danwerner21/mini68k/hardware/mfpic/INT-NS32202.tif

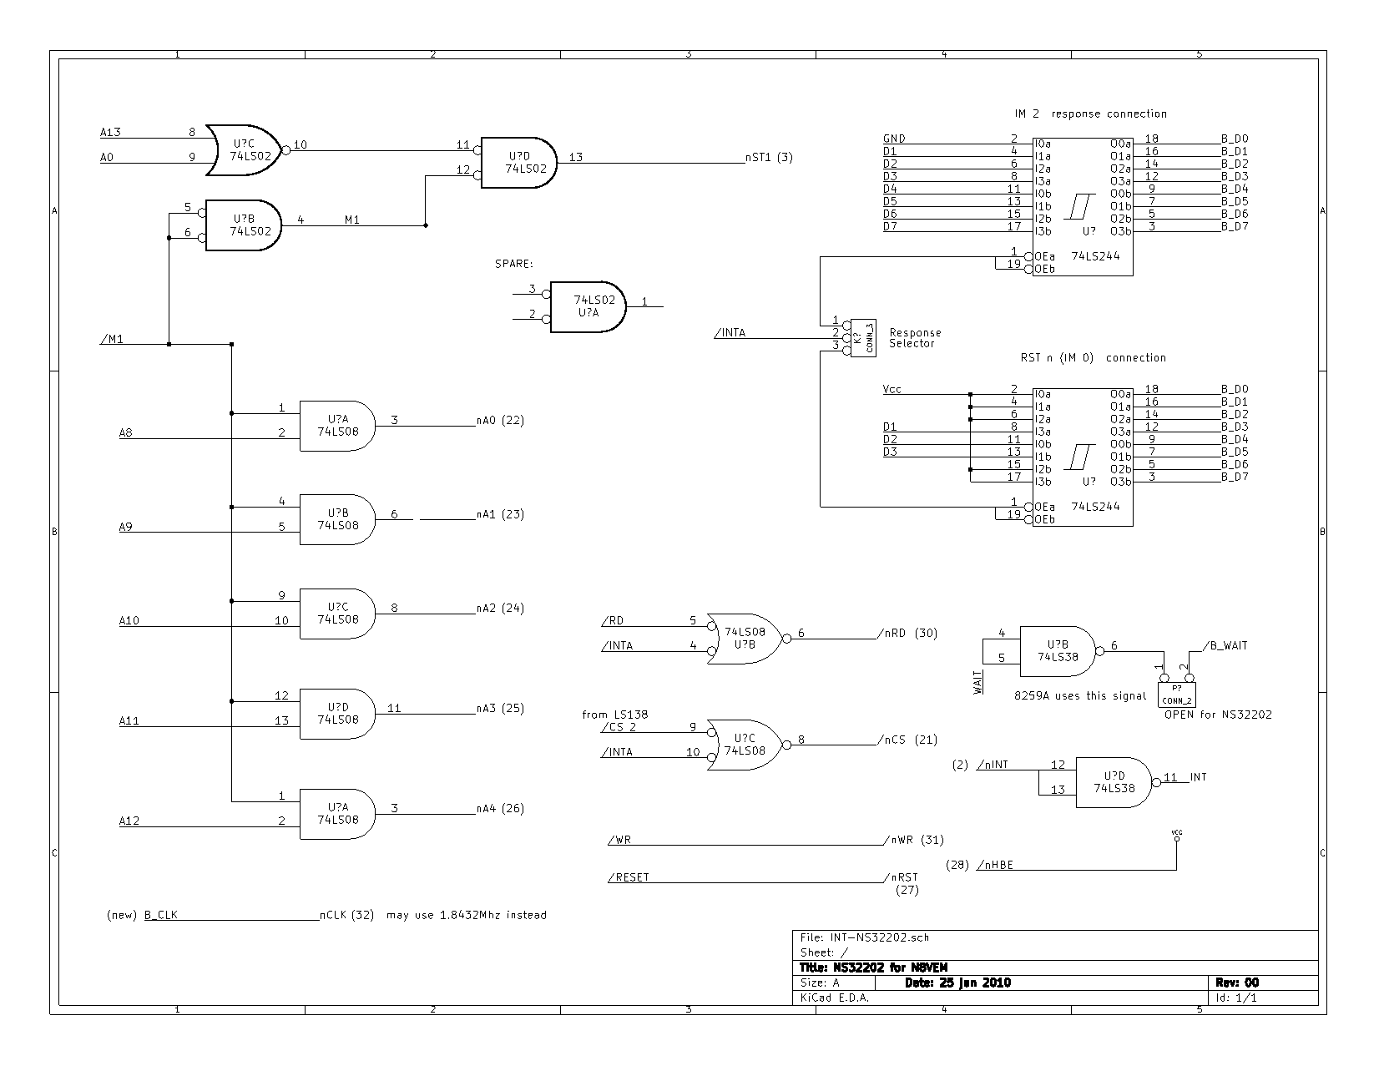
hardware/mfpic/INT-NS32202.tif
