danwerner21/mini68k/hardware/sbc/PC-bot-mirror.png

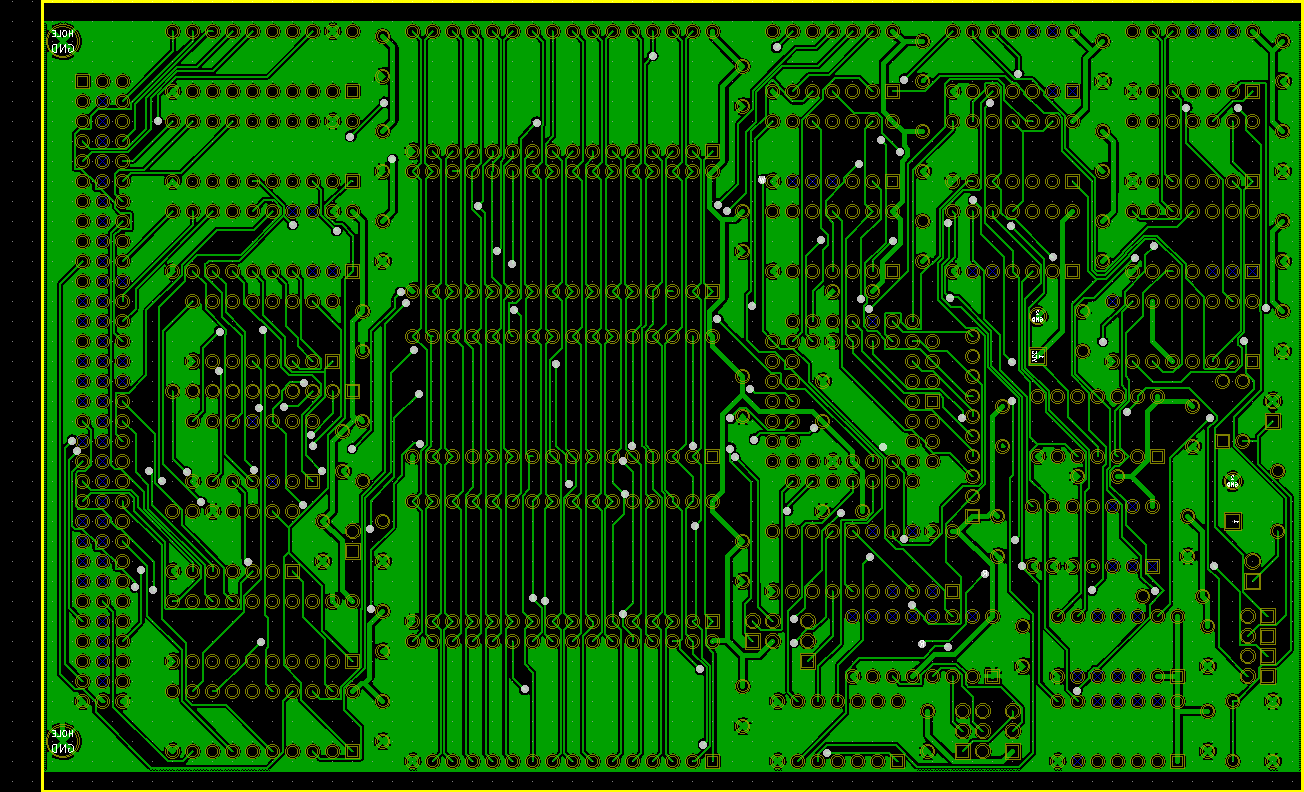
hardware/sbc/PC-bot-mirror.png
