danwerner21/mini68k/hardware/sbc/PC-bottom.png

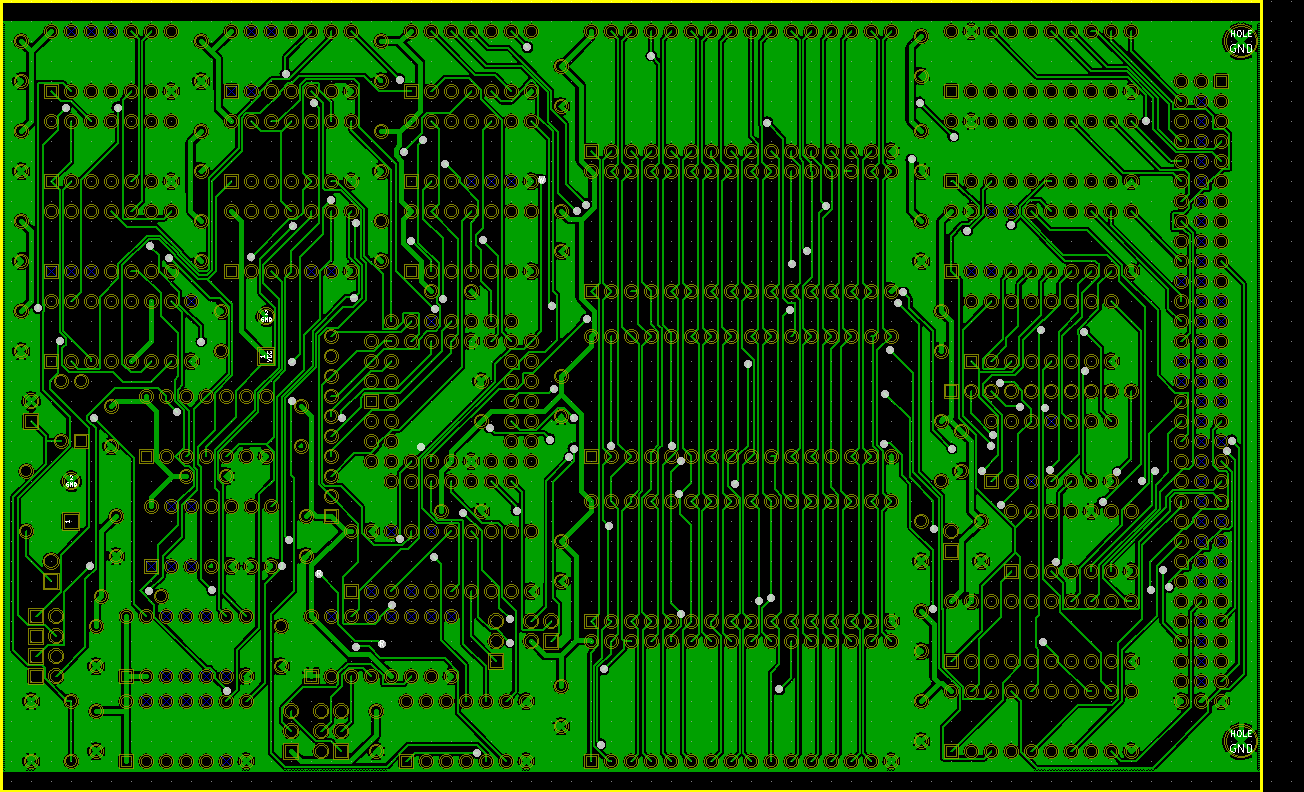
hardware/sbc/PC-bottom.png
