danwerner21/mini68k/hardware/sbc/PC-top.png

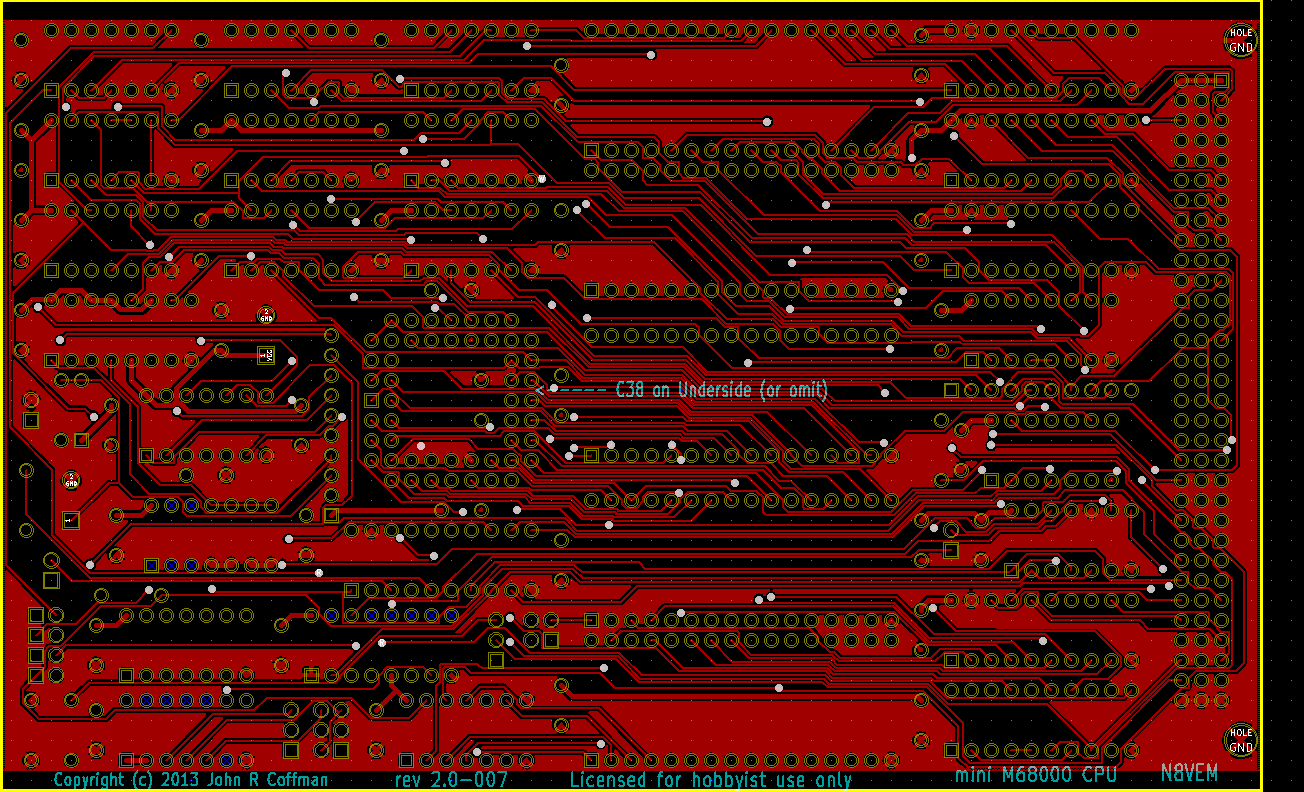
hardware/sbc/PC-top.png
