danwerner21/mini68k/hardware/sbc/Placement.png

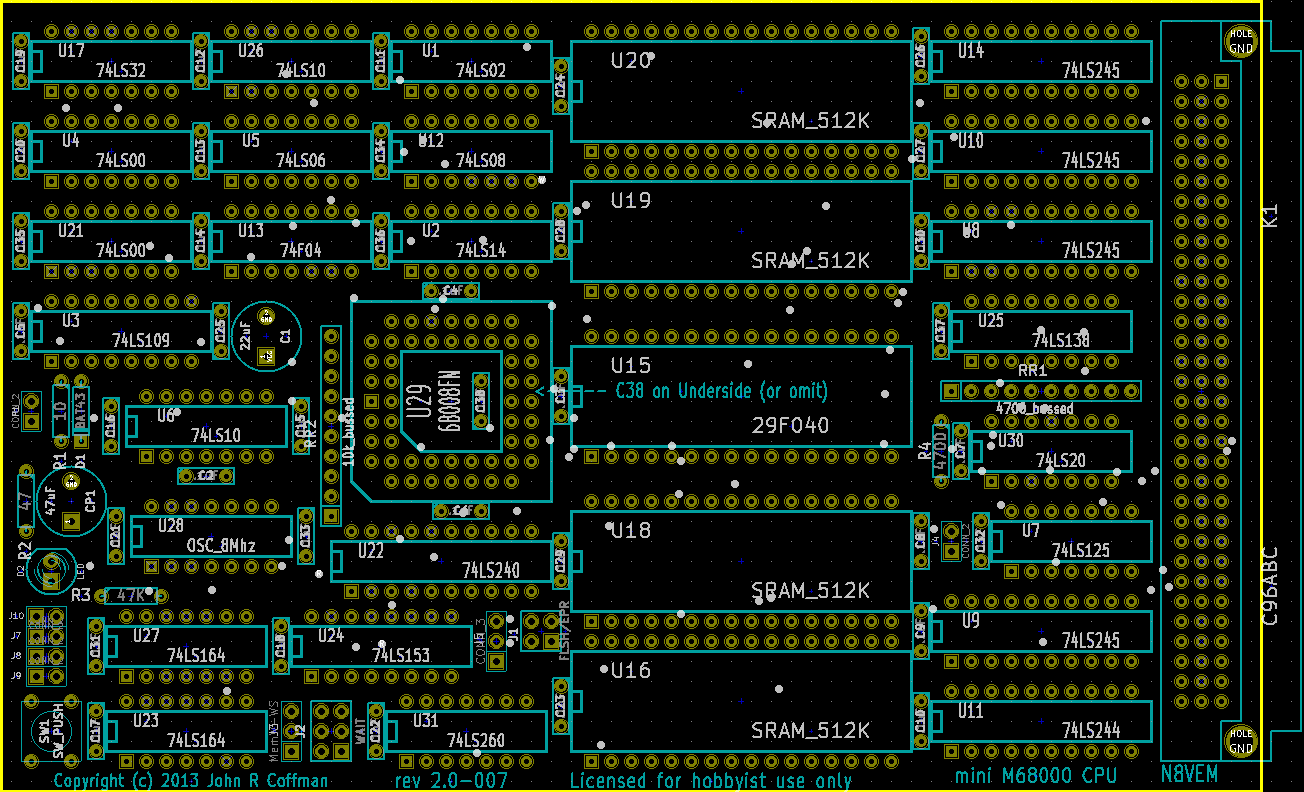
hardware/sbc/Placement.png
