danwerner21/mini68k/hardware/sbc/babyM68K.csv

Reference | Qty | Value | DNP | Exclude from BOM | Exclude from Board | Footprint | Datasheet
C1 | 1 | 22uF
C2,C3,C4,C5,C6,C7,C8,C9,C10,C11,C12,C13,C14,C15,C16,C17,C18,C19,C20,C21,C22,C23,C24,C25,C26,C27,C28,C29,C30,C31,C32,C33,C34,C35,C36,C37,C38 | 37 | .1uF
CP1 | 1 | 47uF
D1 | 1 | BAT43
D2 | 1 | LED
J1 | 1 | FLSH/EPR
J2 | 1 | WAIT
J3 | 1 | MemW-WS
J4,J7,J8,J9,J10,P1 | 6 | CONN_2
J5 | 1 | CONN_3
K1 | 1 | C96ABC
R1 | 1 | 10
R2 | 1 | 47
R3 | 1 | 47K
R4 | 1 | 4700
RR1 | 1 | 4700 bussed
RR2 | 1 | 10k bussed
SW1 | 1 | SW_PUSH
U1A?,U1B?,U1C?,U1D? | 4 | 74LS02
U2A?,U2B?,U2C?,U2D?,U2E?,U2F? | 6 | 74LS14
U3A?,U3B? | 2 | 74LS109
U4A?,U4B?,U4C?,U4D?,U21,U21B?,U21C?,U21D? | 8 | 74LS00
U5A?,U5B?,U5C?,U5D?,U5E?,U5F? | 6 | 74LS06
U6A?,U6B?,U6C?,U26,U26B?,U26C? | 6 | 74LS10
U7A?,U7B?,U7C?,U7D? | 4 | 74LS125
U8,U9,U10,U14 | 4 | 74LS245
U11 | 1 | 74LS244
U12,U12A?,U12C?,U12D? | 4 | 74LS08
U13,U13A?,U13B?,U13D?,U13E?,U13F? | 6 | 74F04
U15 | 1 | 29F040
U16,U18,U19,U20 | 4 | SRAM_512K
U17,U17A?,U17B?,U17C? | 4 | 74LS32
U22 | 1 | 74LS240
U23,U27 | 2 | 74LS164
U24 | 1 | 74LS153
U25 | 1 | 74LS138
U28 | 1 | OSC 8Mhz
U29 | 1 | 68008FN |  |  |  | PLCC52
U30A?,U30B? | 2 | 74LS20
U31A?,U31B? | 2 | 74LS260
