danwerner21/mini68k/hardware/mfpic/PIC-007-sch.pdf

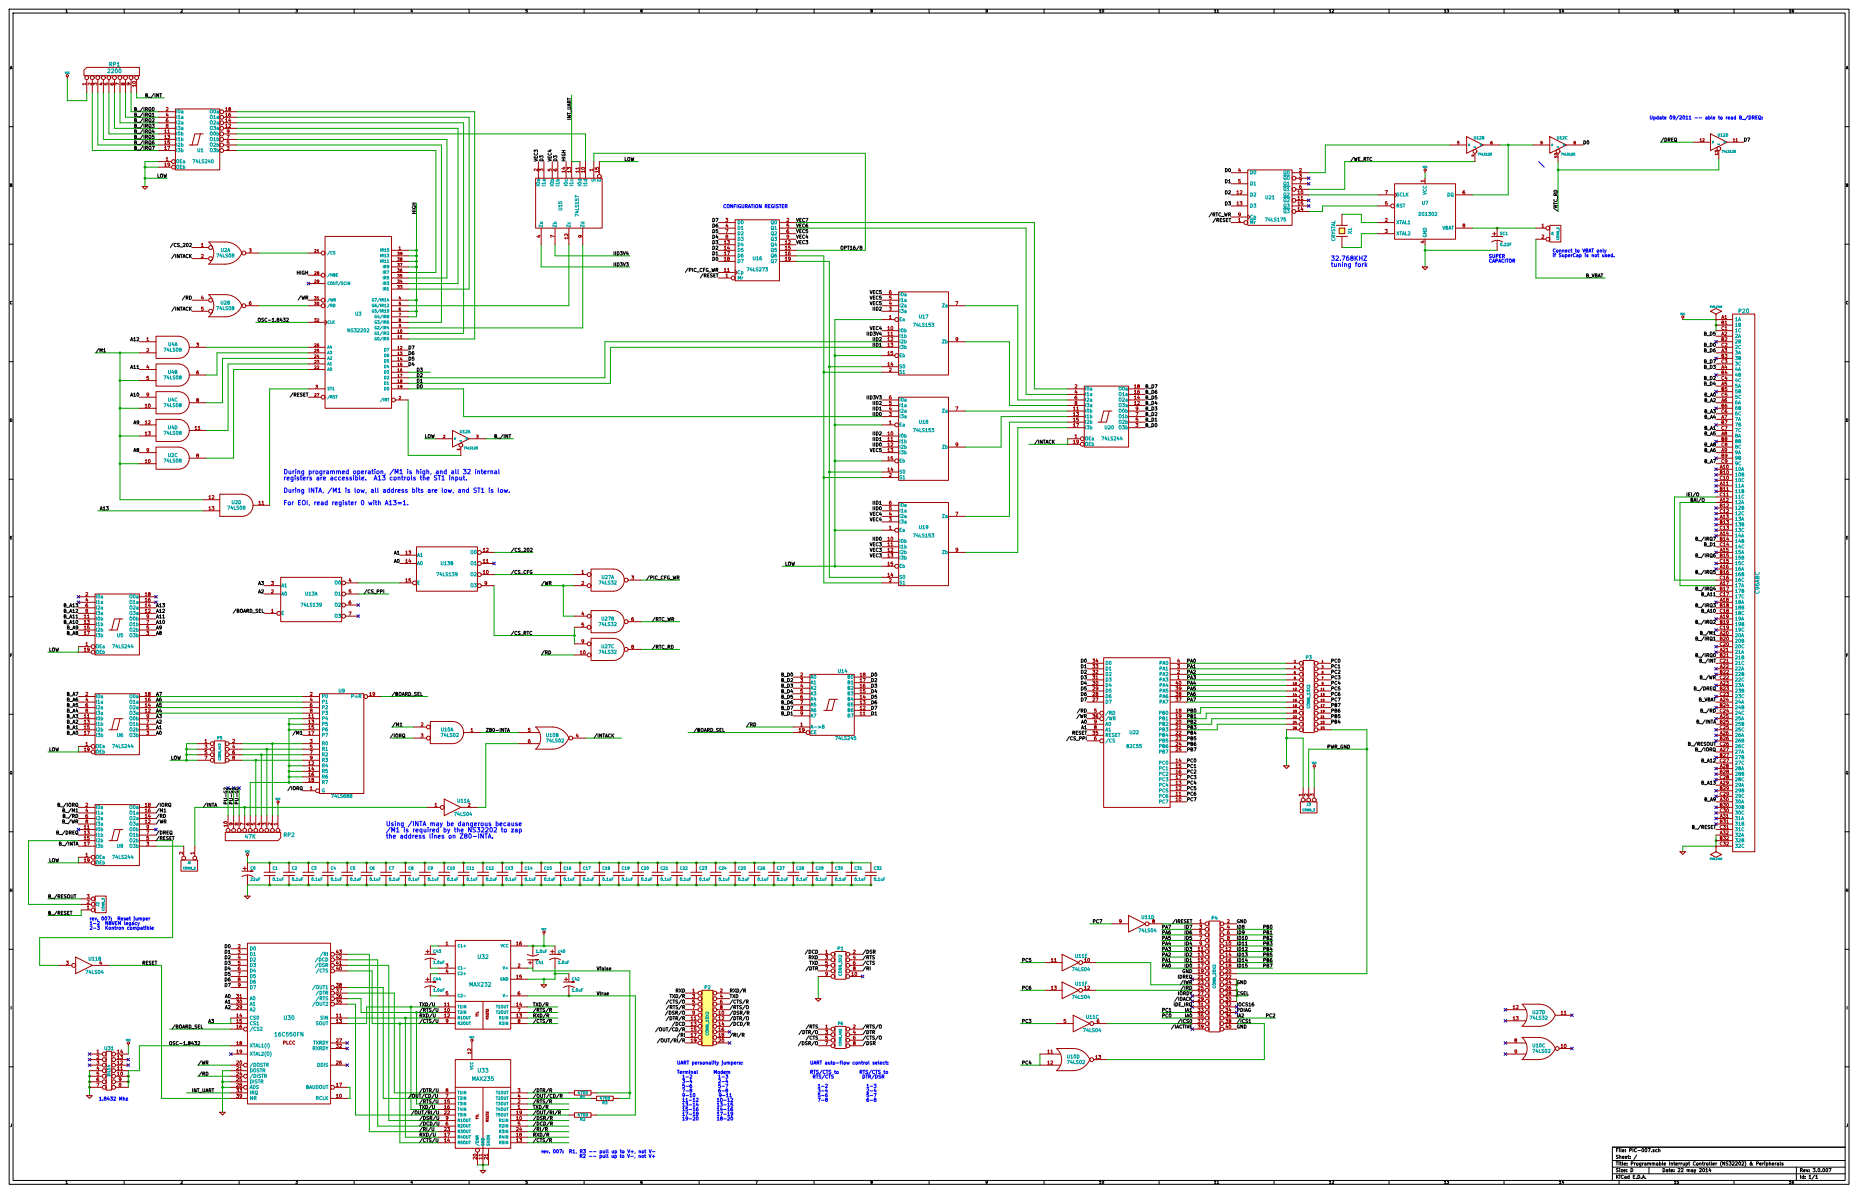
[picture p9: page 1]

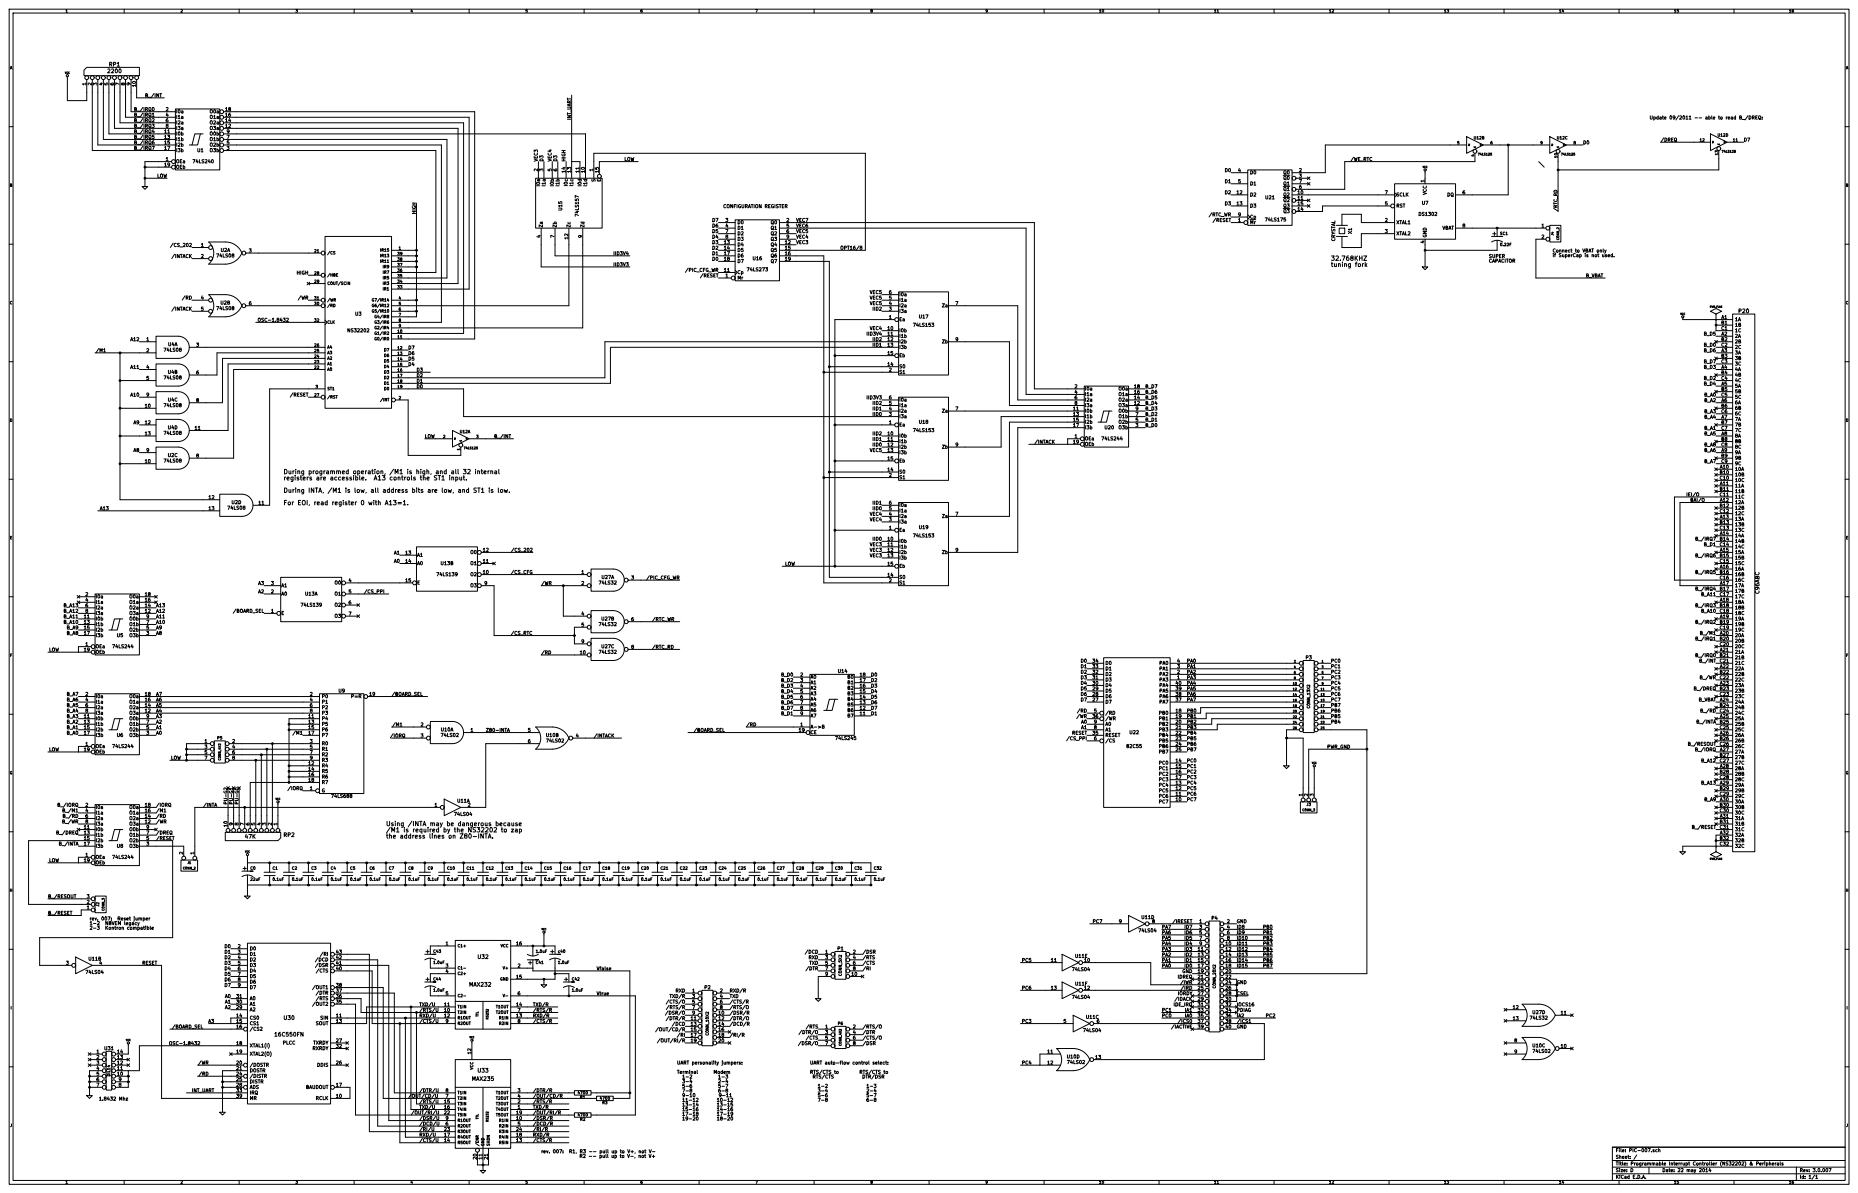
[picture p10: page 2]
