danwerner21/mini68k/(list of files, drawings)

Other design files:
hardware/mfpic/PIC-007-88.dsn
hardware/mfpic/PIC-007.dsn
hardware/sbc/babyM68K-112c.dsn
hardware/sbc/babyM68K.dsn
