danwerner21/mini68k/hardware/sbc/babyM68K.kicad_pcb

## KiCad design hardware/sbc/babyM68K.kicad_pcb (2026-08-16)

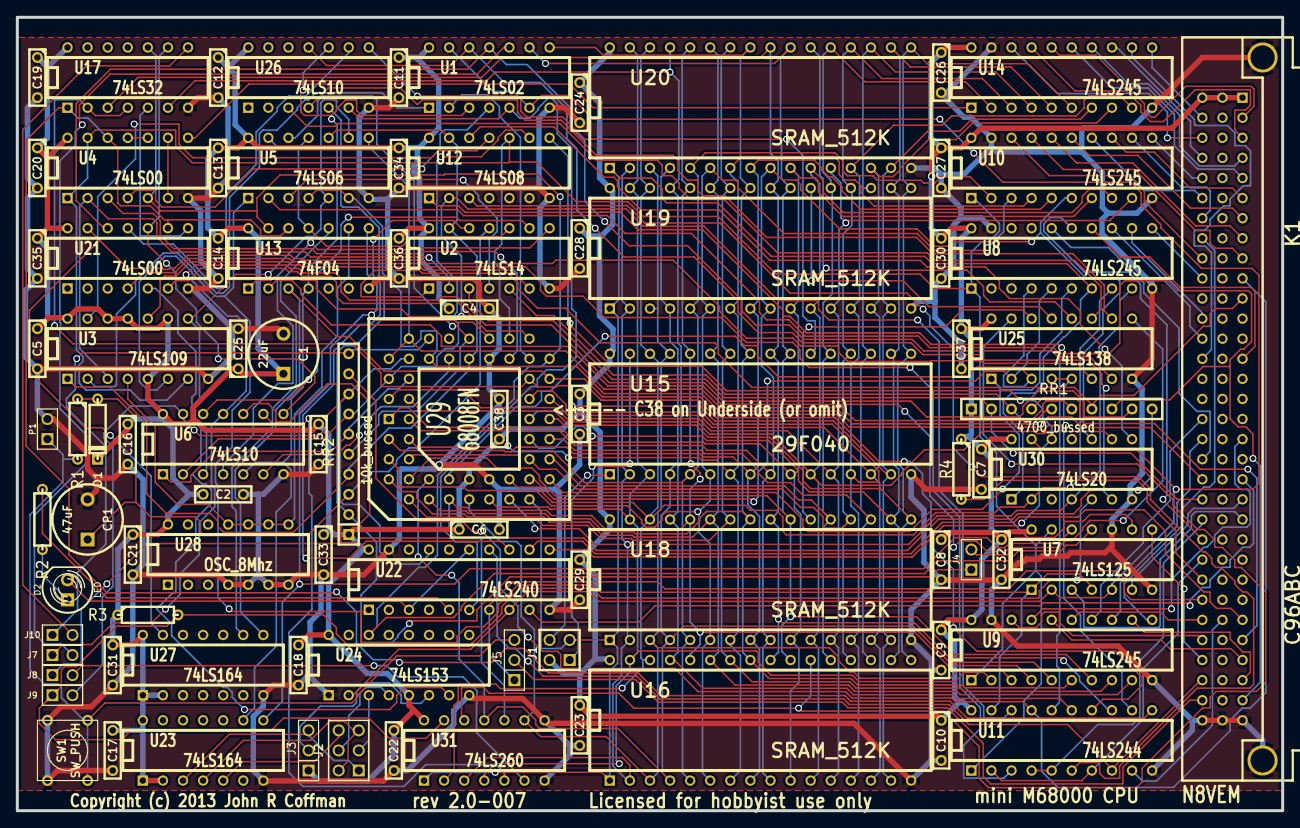
[picture p11: board babyM68K.kicad_pcb from above]

Board: 2 copper layers, 160.0 x 100.3 mm, 90 parts (0 on the bottom side), 163 nets.

Parts:
C1: 22uF; C2V8
C2, C3, C4, C5, C6, C7, C8, C9, C10, C11, C12, C13, C14, C15, C16, C17, C18, C19, C20, C21, C22, C23, C24, C25, C26, C27, C28, C29, C30, C31, C32, C33, C34, C35, C36, C37, C38: .1uF; C2
CP1: 47uF; C2V8
D1: BAT43; D3
D2: LED; LED-5MM-POL
J1: FLSH/EPR; PIN_ARRAY_2X2
J2: WAIT; pin_array_3x2
J3: MemW-WS; PIN_ARRAY_3X1
J4, J7, J8, J9, J10: CONN_2; PIN_ARRAY_2X1
J5: CONN_3; PIN_ARRAY_3X1
K1: C96ABC; C96ABCMC_52
P1: CONN_2; PIN_ARRAY_2X1
R1: 10; R3
R2: 47; R3
R3: 47K; R3
R4: 4700; R3
RR1: 4700_bussed; r_pack9
RR2: 10k_bussed; r_pack9
SW1: SW_PUSH; SW_PUSH_SMALL
U1: 74LS02; DIP-14__300_52
U2: 74LS14; DIP-14__300_52
U3: 74LS109; DIP-16__300_52
U4, U21: 74LS00; DIP-14__300_52
U5: 74LS06; DIP-14__300_52
U6, U26: 74LS10; DIP-14__300_52
U7: 74LS125; DIP-14__300_52
U8, U9, U10, U14: 74LS245; DIP-20__300_52
U11: 74LS244; DIP-20__300_52
U12: 74LS08; DIP-14__300_52
U13: 74F04; DIP-14__300_52
U15: 29F040; DIP-32__600_52
U16, U18, U19, U20: SRAM_512K; DIP-32__600_52
U17: 74LS32; DIP-14__300_52
U22: 74LS240; DIP-20__300_52
U23, U27: 74LS164; DIP-14__300_52
U24: 74LS153; DIP-16__300_52
U25: 74LS138; DIP-16__300_52
U28: OSC_8Mhz; DIP-14__300_52
U29: 68008FN; PLCC52_52
U30: 74LS20; DIP-14__300_52
U31: 74LS260; DIP-14__300_52

Connections:
/AS: U11.12, U13.3, U25.4, U25.5, U27.8, U29.31
/BERR: J10.1, RR2.10, U29.44
/BG: U1.2, U29.35
/BGACK: U3.7, U4.1, U4.13, U7.13, U8.1, U9.1, U10.1, U11.1, U12.10, U29.36
/BR: U4.3, U29.37
/CLK: U3.4, U13.9, U28.8, U28.9, U28.10, U28.11
/CSRAM0: U16.22, U25.15, U31.12
/CSRAM1: U18.22, U25.14
/CSRAM2: U19.22, U25.13
/CSRAM3: U20.22, U25.12
/DS: U11.14, U17.2, U17.4, U29.32
/DTACK: U21.6, U29.34
/HALT: RR2.5, U5.12, U29.40
/IPL0: RR1.6, U5.8, U29.46, U29.47
/IPL1: RR1.5, U5.4, U5.6, U29.45
/Memory//USERLOWMEM: U6.8, U17.9, U21.10
/POClear: U13.10, U27.9
/RD: U11.13, U15.24, U16.24, U17.3, U18.24, U19.24, U20.24
/RESET: RR2.4, U2.13, U3.1, U5.10, U12.13, U29.41
/ROM: U15.22, U26.8
/Reset//RESET_IN: J5.3, P1.1, R1.2, SW1.2
/Select//IOSPACE: U1.12, U26.11, U30.6
/Select//ROMONLY: U21.13, U25.6, U27.13
/Select/PU-10K-A: J4.1, RR2.2, U26.5
/Tranceivers/D_OUT: U4.8, U14.1
/Tranceivers/LOCAL: U1.4, U4.4
/VPA: U6.6, U29.43
/WAIT: U11.3, U21.4
/WR: U11.15, U16.29, U17.6, U18.29, U19.29, U20.29
/Wait_State/1WS: J2.1, J3.3, U23.3
/Wait_State/2WS: J2.2, J2.5, U23.4
/Wait_State/3WS: J2.6, U23.5
/Wait_State/RDY: U21.5, U24.7
/Wait_State/WS-IORD: J2.3, U24.3
/Wait_State/WS-IOWR: J2.4, U24.4
A0: U10.9, U15.12, U16.12, U18.12, U19.12, U20.12, U29.51
A1: U10.8, U15.11, U16.11, U18.11, U19.11, U20.11, U29.52, U30.9
A2: U10.7, U15.10, U16.10, U18.10, U19.10, U20.10, U29.1
A3: U10.6, U15.9, U16.9, U18.9, U19.9, U20.9, U29.2, U30.10
A4: U10.5, U15.8, U16.8, U18.8, U19.8, U20.8, U29.3
A5: U10.4, U15.7, U16.7, U18.7, U19.7, U20.7, U29.4
A6: U10.3, U15.6, U16.6, U18.6, U19.6, U20.6, U29.5
A7: U10.2, U15.5, U16.5, U18.5, U19.5, U20.5, U29.6
A8: U9.9, U15.27, U16.27, U18.27, U19.27, U20.27, U29.7
A9: U9.8, U15.26, U16.26, U18.26, U19.26, U20.26, U29.8
A10: U1.9, U9.7, U15.23, U16.23, U18.23, U19.23, U20.23, U29.9
A11: U1.8, U9.6, U15.25, U16.25, U18.25, U19.25, U20.25, U29.10
A12: U9.5, U15.4, U16.4, U18.4, U19.4, U20.4, U29.11, U31.11
A13: U9.4, U15.28, U16.28, U18.28, U19.28, U20.28, U29.12, U31.10
A14: U9.3, U15.29, U16.3, U18.3, U19.3, U20.3, U29.14, U31.9
A15: U9.2, U15.3, U16.31, U18.31, U19.31, U20.31, U29.16, U31.4
A16: U8.9, U15.2, U16.2, U18.2, U19.2, U20.2, U29.18, U30.4, U31.3
A17: U8.8, U15.30, U16.30, U18.30, U19.30, U20.30, U29.19, U30.2, U31.2
A18: J1.3, U8.7, U16.1, U18.1, U19.1, U20.1, U29.20, U30.1, U31.1
A19: U8.6, U25.1, U29.21
A20: U8.5, U25.2, U29.22
A21: U8.4, U25.3, U29.13
AS: U1.3, U6.5, U13.4, U23.9, U26.10
BUSAK: U3.6, U5.1, U7.1, U7.4, U11.19, U22.1
B_/BUSAK: K1.A31, RR1.8, U5.2
B_/BUSRQ: K1.A11, RR1.7, U2.1
B_/CLK: K1.C29, U7.8
B_/HALT: K1.C25, R4.2
B_/INT: K1.C21, RR1.2, U2.3
B_/IORQ: K1.A27, U22.12
B_/M1: K1.A20, U22.9
B_/MREQ: K1.C30, U11.8, U22.14
B_/NMI: K1.C20, RR1.3, U2.5
B_/RD: K1.C24, U11.2, U11.7
B_/RESET: J5.2, K1.C31
B_/RESOUT: J5.1, K1.C26, U22.7
B_/RFSH: K1.A28, RR1.4
B_/WAIT: K1.A10, RR2.9, U11.17
B_/WR: K1.C22, U11.4, U11.5
B_A0: K1.C5, U10.11
B_A1: K1.C7, U10.12
B_A2: K1.A6, U10.13
B_A3: K1.C6, U10.14
B_A4: K1.A7, U10.15
B_A5: K1.A8, U10.16
B_A6: K1.A9, U10.17
B_A7: K1.C9, U10.18
B_A8: K1.C8, U9.11
B_A9: K1.A30, U9.12
B_A10: K1.C18, U9.13
B_A11: K1.C17, U9.14
B_A12: K1.C27, U9.15
B_A13: K1.A29, U9.16
B_A14: K1.A18, U9.17
B_A15: K1.C28, U9.18
B_A16: K1.C10, U8.11
B_A17: K1.C12, U8.12
B_A18: K1.C13, U8.13
B_A19: K1.A14, U8.14
B_A20: K1.C23, U8.15
B_A21: K1.C19, U8.16
B_A22: K1.A21, U7.6
B_A23: K1.A22, U7.3
B_D0: K1.C2, U14.11
B_D1: K1.C14, U14.12
B_D2: K1.C4, U14.13
B_D3: K1.A4, U14.14
B_D4: K1.A5, U14.15
B_D5: K1.A2, U14.16
B_D6: K1.A3, U14.17
B_D7: K1.C3, U14.18
B_DT/R: K1.B27, U11.9
CLK: U7.9, U13.8, U23.8, U29.38
D0: U14.9, U15.13, U16.13, U18.13, U19.13, U20.13, U29.30
D1: U14.8, U15.14, U16.14, U18.14, U19.14, U20.14, U29.29
D2: U14.7, U15.15, U16.15, U18.15, U19.15, U20.15, U29.28
D3: U14.6, U15.17, U16.17, U18.17, U19.17, U20.17, U29.27
D4: U14.5, U15.18, U16.18, U18.18, U19.18, U20.18, U29.26
D5: U14.4, U15.19, U16.19, U18.19, U19.19, U20.19, U29.25
D6: U14.3, U15.20, U16.20, U18.20, U19.20, U20.20, U29.24
D7: U14.2, U15.21, U16.21, U18.21, U19.21, U20.21, U29.23
FC0: RR2.6, U6.1, U29.50
FC1: RR2.7, U6.2, U12.9, U29.49
FC2: J9.2, RR2.8, U6.13, U22.17, U29.48
GND: C1.2, C2.2, C3.2, C4.2, C5.2, C6.2, C7.2, C8.2, C9.2, C10.2, C11.2, C12.2, C13.2, C14.2, C15.2, C16.2, C17.2, C18.2, C19.2, C20.2, C21.2, C22.2, C23.2, C24.2, C25.2, C26.2, C27.2, C28.2, C29.2, C30.2, C31.2, C32.2, C33.2, C34.2, C35.2, C36.2, C37.2, C38.2, CP1.2, K1.A32, K1.B32, K1.C32, K1.HOLE, P1.2, SW1.1, U1.7, U2.7, U3.8, U4.7, U5.7, U6.7, U7.7, U7.10, U8.10, U8.19, U9.10, U9.19, U10.10, U10.19, U11.10, U12.7, U13.7, U14.10, U14.19, U15.16, U16.16, U17.7, U18.16, U19.16, U20.16, U21.7, U22.10, U22.19, U23.7, U24.1, U24.8, U25.8, U26.7, U27.7, U28.4, U28.5, U28.6, U28.7, U29.17, U29.39, U30.7, U31.7, U31.8
IORQ: U1.6, U1.13, U7.2, U7.5, U22.8, U24.2, U30.13
M1: U12.8, U22.11, U30.12
MREQ: U1.5, U22.6, U26.6
unnamed: U21.11, U26.9
unnamed: U1.11, U21.12, U25.7
unnamed: J4.2, U25.9
unnamed: U25.10, U26.4
unnamed: U25.11, U26.3
unnamed: J3.2, U24.6
unnamed: R2.1, U22.5
unnamed: D2.1, R2.2
unnamed: D2.2, U22.3, U22.15
unnamed: U2.10, U5.11, U5.13, U13.11
unnamed: J1.4, U15.1
unnamed: J8.2, U31.6
unnamed: U17.5, U21.8
unnamed: J1.1, U15.31
unnamed: U6.9, U31.5
unnamed: J7.2, U1.10
unnamed: J10.2, U17.8
unnamed: U11.16, U12.1
unnamed: U11.18, U12.2, U13.1
unnamed: U11.6, U12.3
unnamed: U4.10, U4.11
unnamed: U7.12, U13.2
unnamed: U4.6, U4.9
unnamed: U12.12, U30.8
unnamed: U3.10, U5.5, U5.9, U6.3
unnamed: U3.15, U12.11
unnamed: U2.6, U3.12
unnamed: U2.4, U5.3
unnamed: U2.8, U6.4
unnamed: U2.9, U6.12
unnamed: U2.2, U3.3, U4.2
unnamed: U1.1, U3.2
PU-10K-clear: CP1.1, D1.1, R1.1, RR2.3, U2.11
PU_MEM4K/1K: J7.1, RR1.9, U6.11
PU_MEM64K/4K: J8.1, RR1.10, U6.10
R/W: U4.5, U7.11, U13.13, U17.10, U24.14, U29.33
RESET: U2.12, U22.13
SUPV/USER: J9.1, R3.2, U30.5, U31.13
VCC: C1.1, C2.1, C3.1, C4.1, C5.1, C6.1, C7.1, C8.1, C9.1, C10.1, C11.1, C12.1, C13.1, C14.1, C15.1, C16.1, C17.1, C18.1, C19.1, C20.1, C21.1, C22.1, C23.1, C24.1, C25.1, C26.1, C27.1, C28.1, C29.1, C30.1, C31.1, C32.1, C33.1, C34.1, C35.1, C36.1, C37.1, C38.1, D1.2, J1.2, J3.1, K1.A1, K1.B1, K1.C1, R3.1, R4.1, RR1.1, RR2.1, U1.14, U2.14, U3.5, U3.11, U3.13, U3.14, U3.16, U4.14, U5.14, U6.14, U7.14, U8.20, U9.20, U10.20, U11.20, U12.14, U13.14, U14.20, U15.32, U16.32, U17.14, U18.32, U19.32, U20.32, U21.14, U22.20, U23.1, U23.2, U23.14, U24.5, U24.16, U25.16, U26.14, U27.1, U27.2, U27.14, U28.14, U29.15, U30.14, U31.14
W/R: U4.12, U11.11, U13.12, U17.1, U21.9
