danwerner21/mini68k/hardware/mfpic/PIC-007.kicad_sch

## KiCad design hardware/mfpic/PIC-007.kicad_sch (2026-10-05)

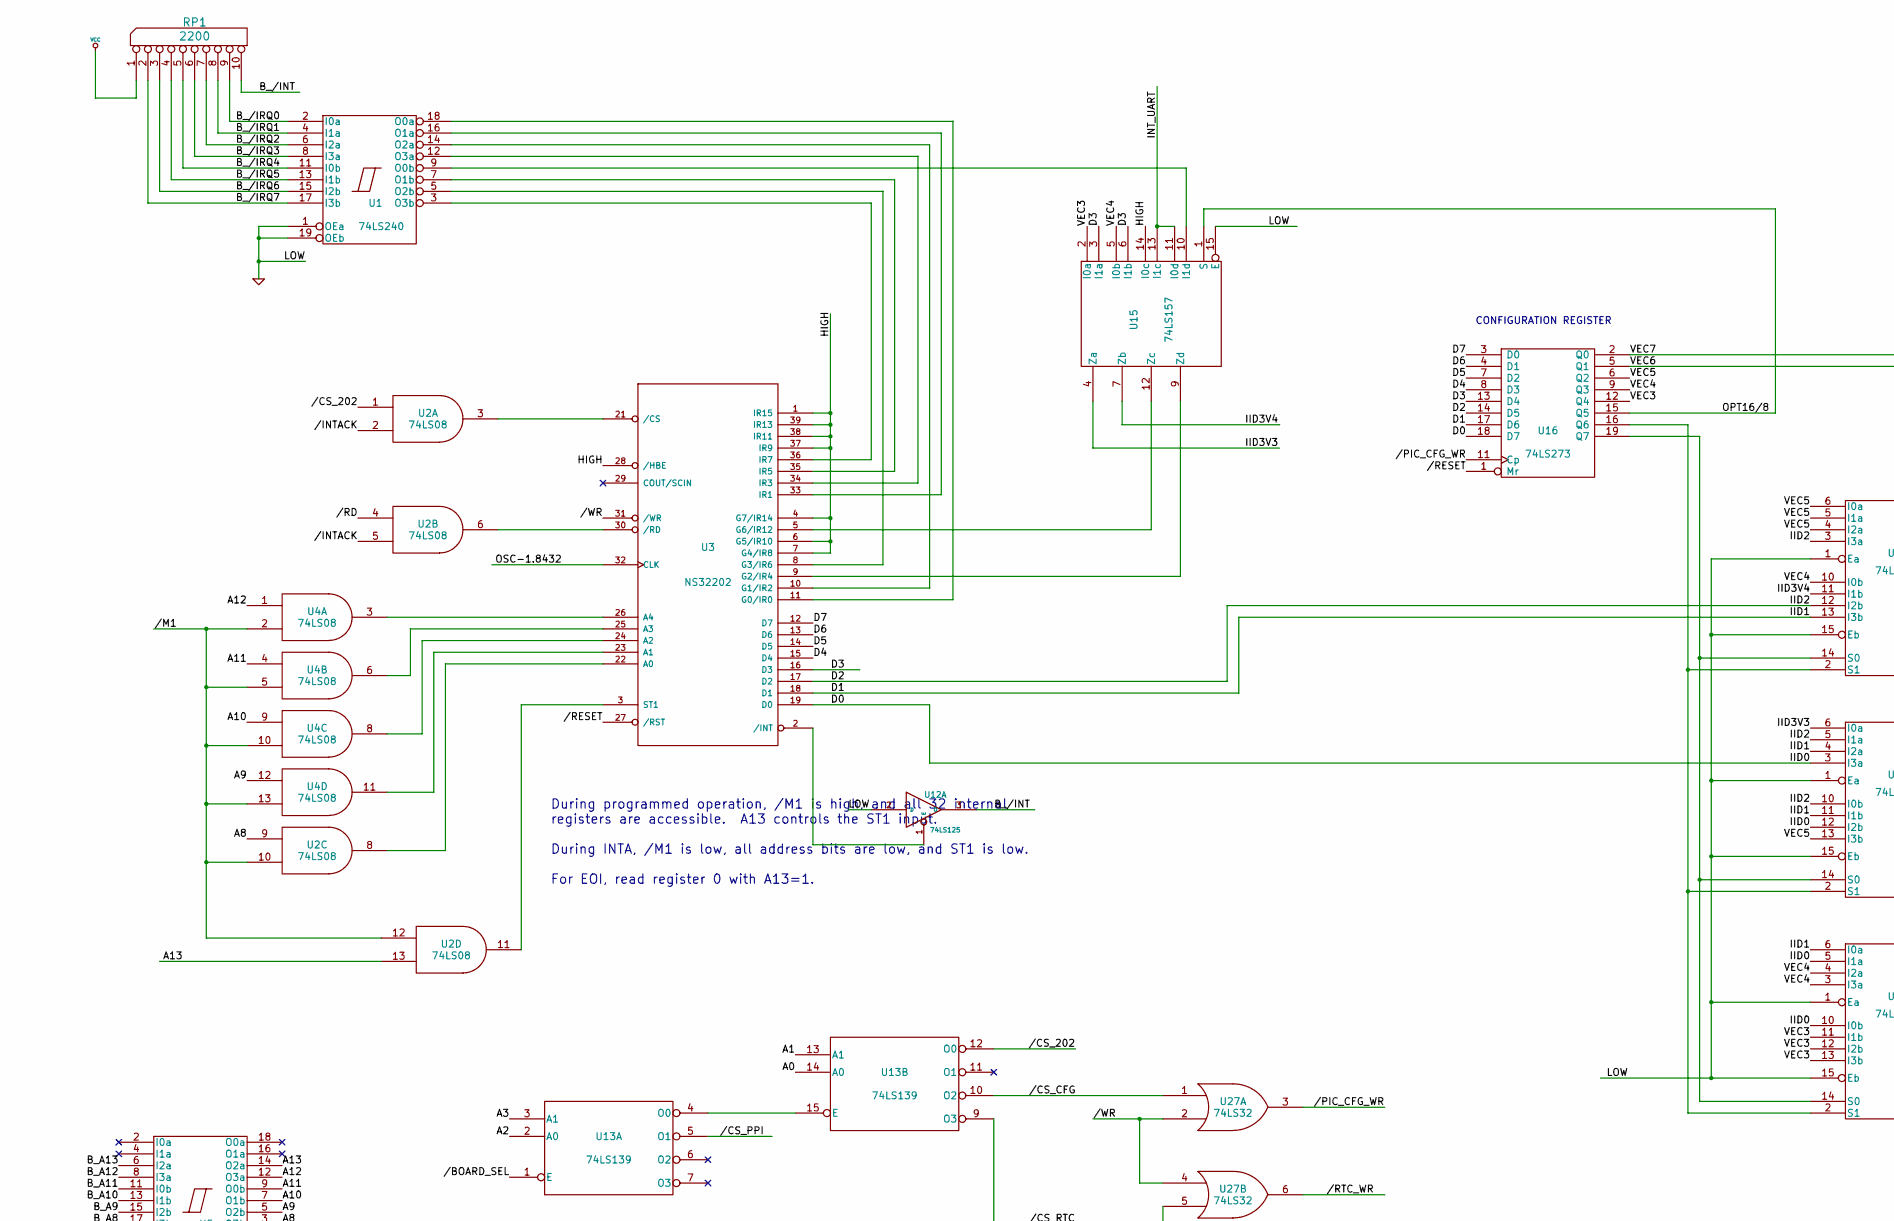
[picture p12: schematic PIC-007.kicad_sch, part in row 1, column 1]

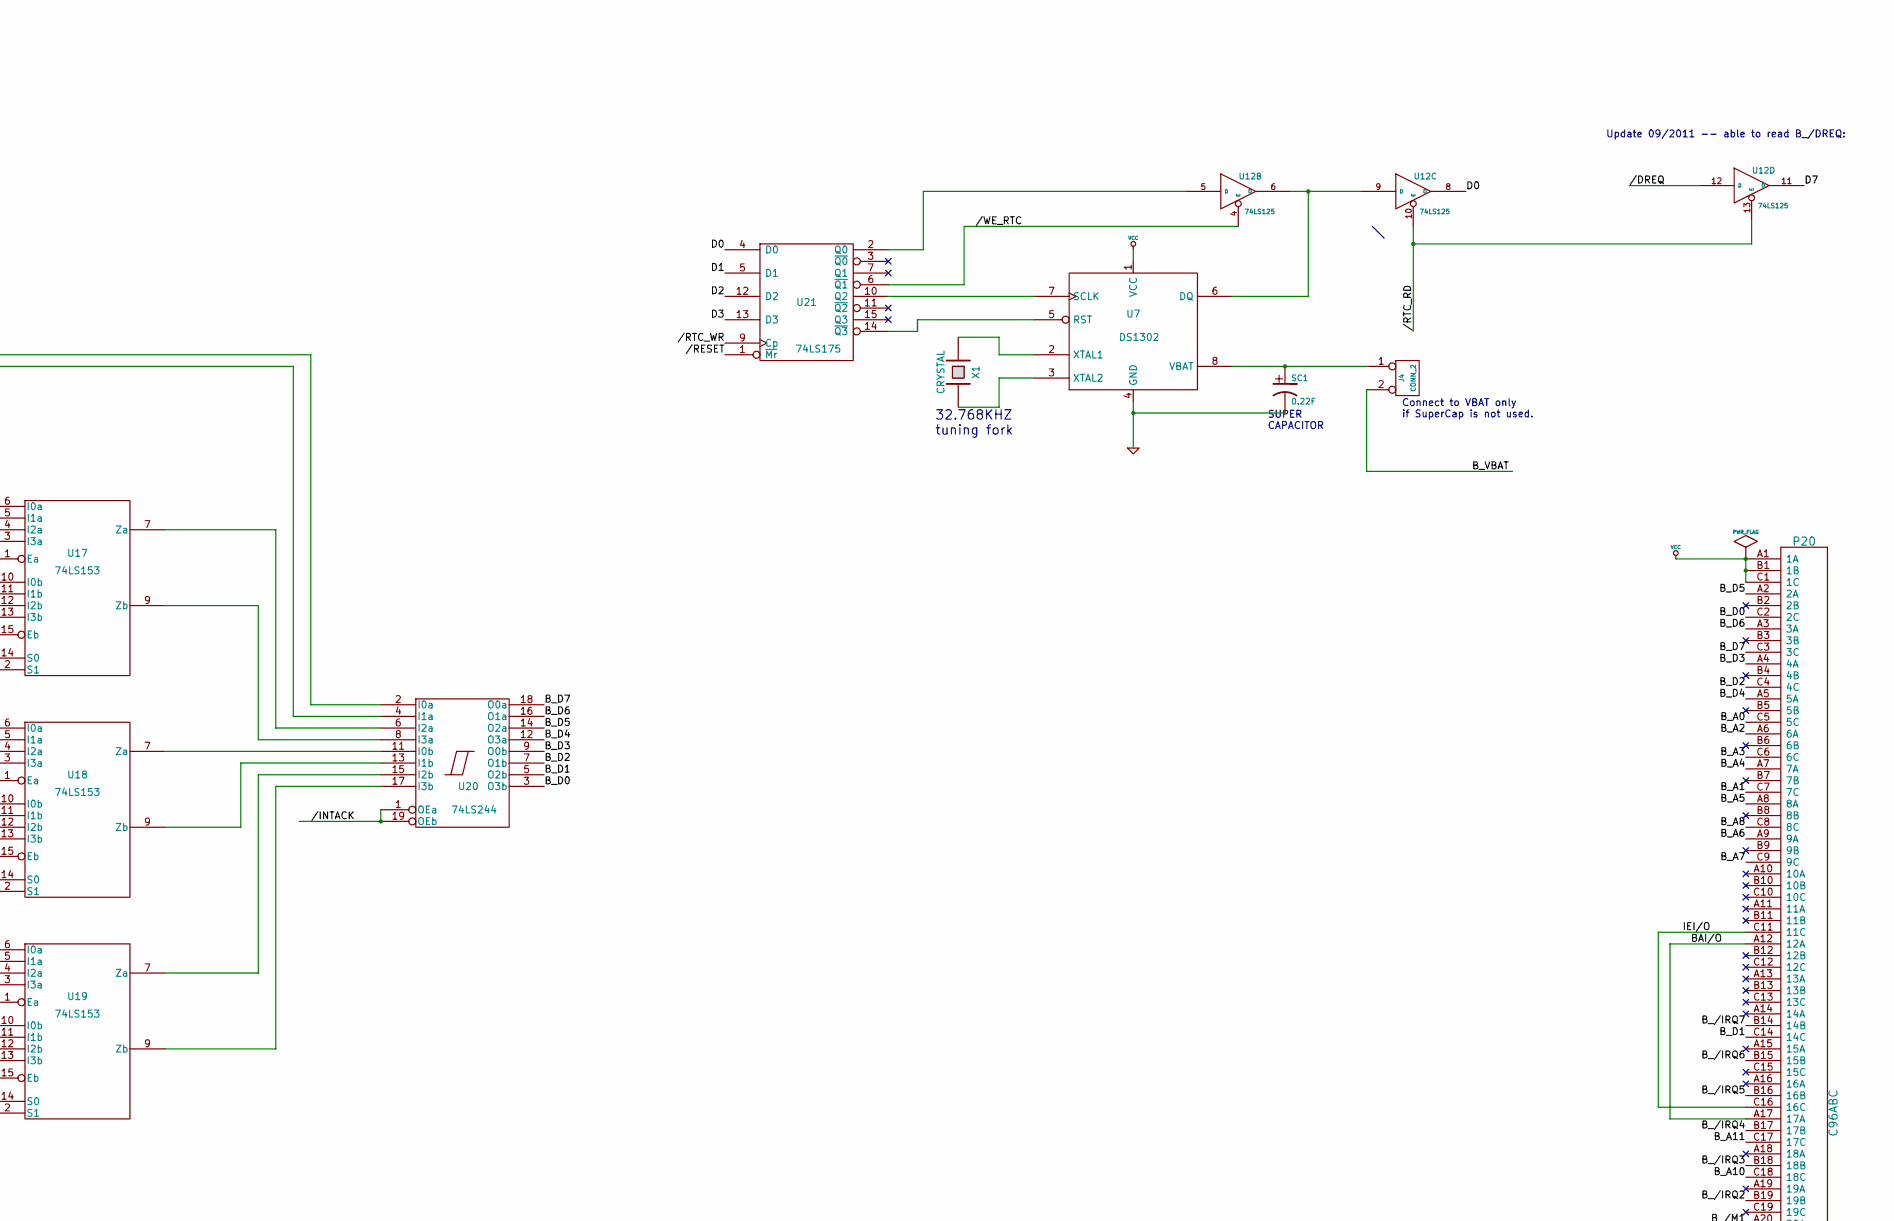
[picture p13: schematic PIC-007.kicad_sch, part in row 1, column 2]

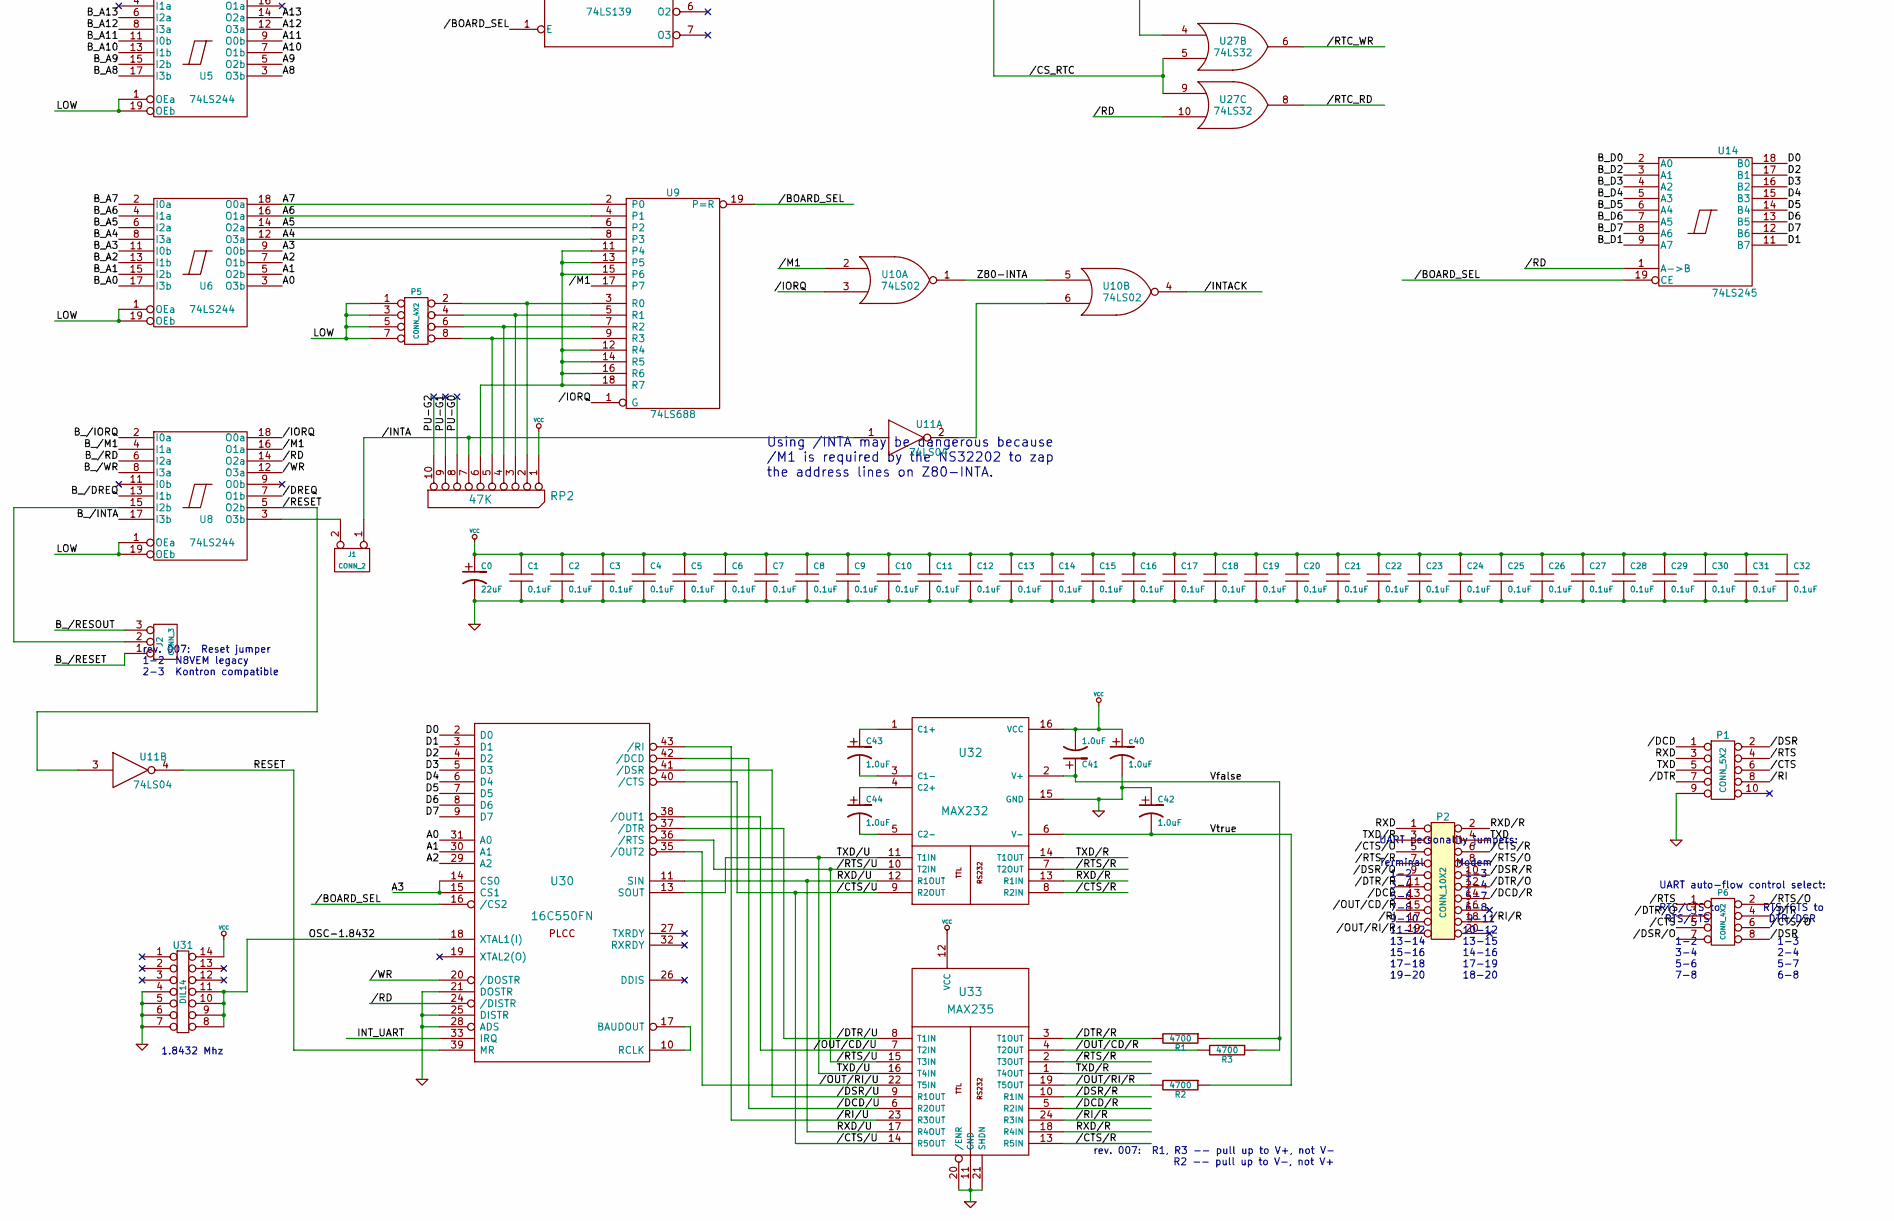
[picture p14: schematic PIC-007.kicad_sch, part in row 2, column 1]

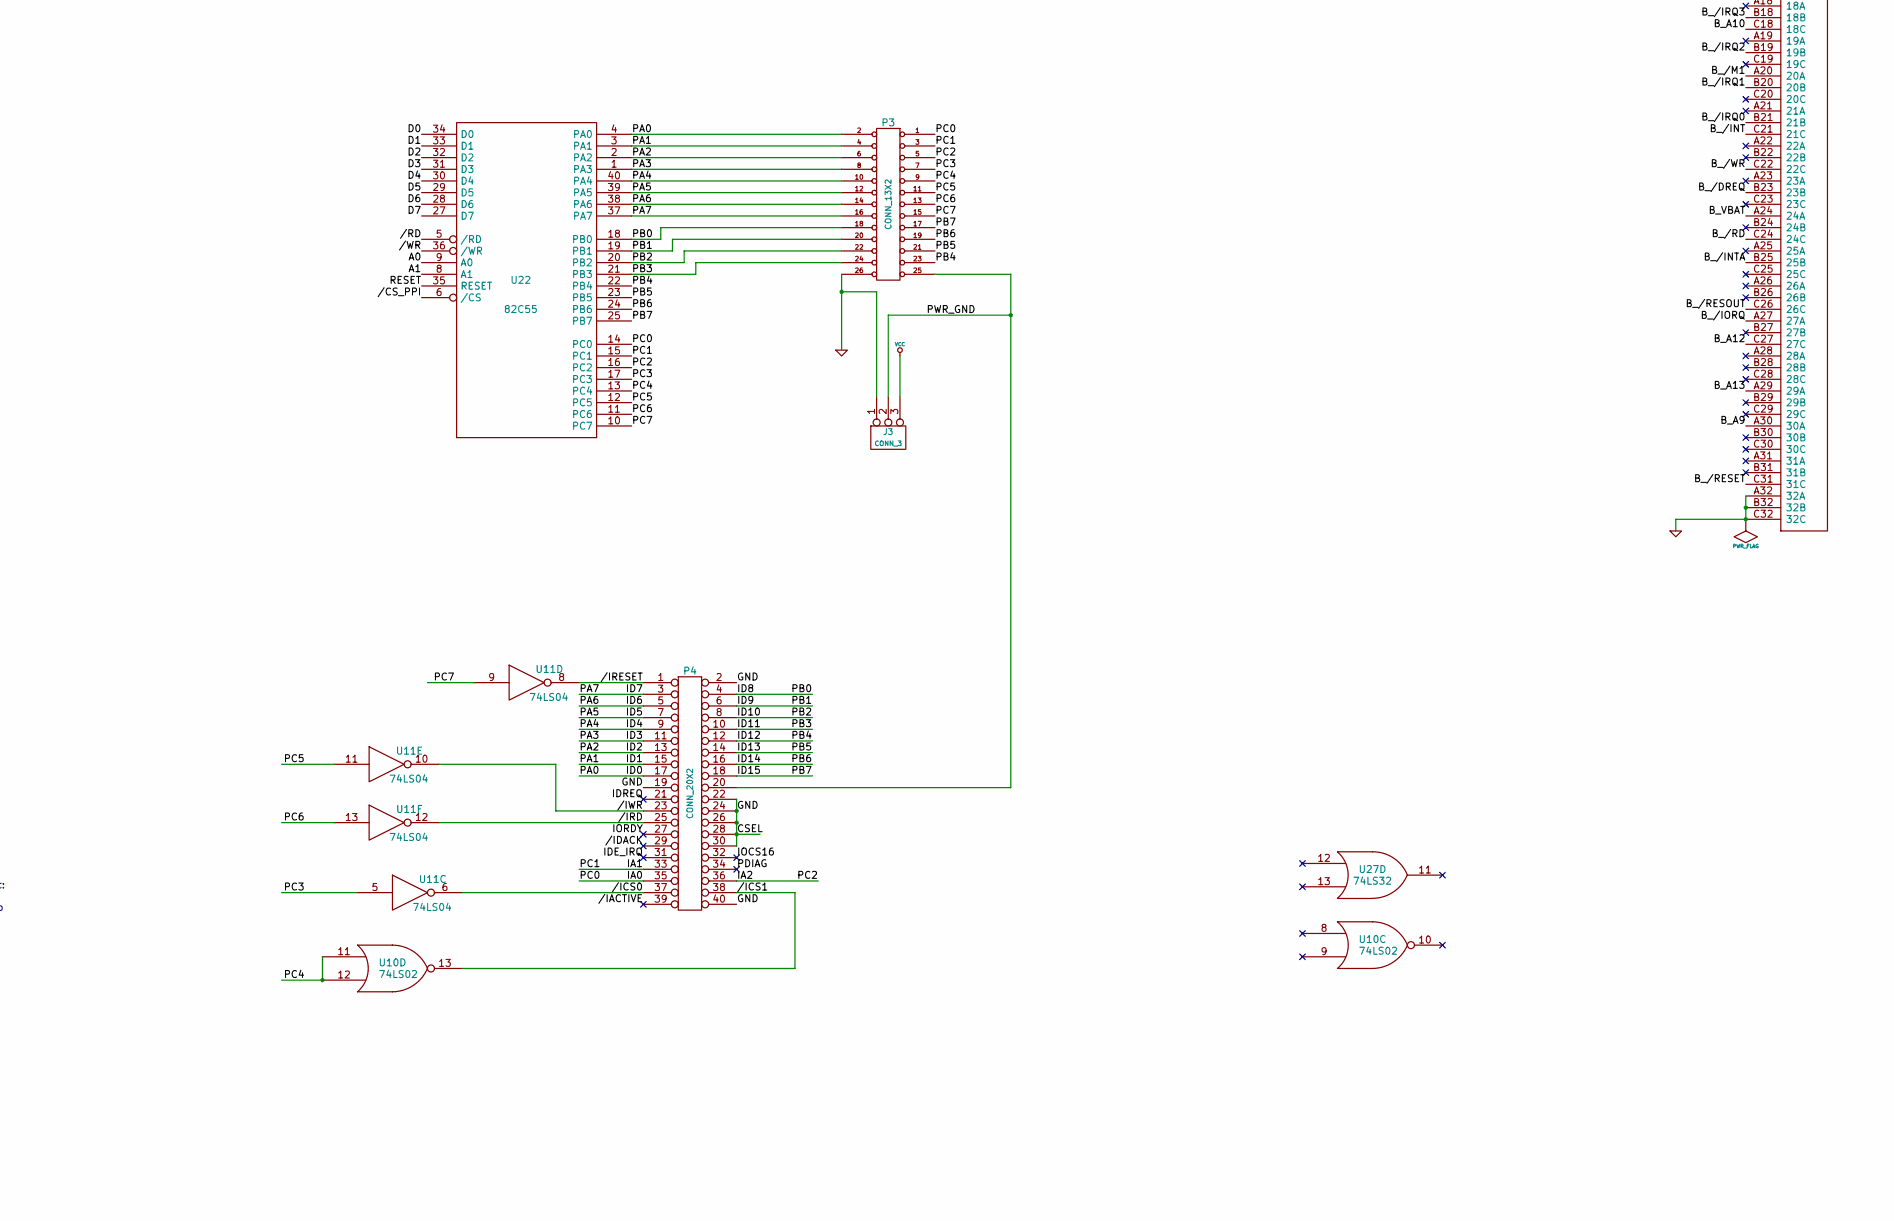
[picture p15: schematic PIC-007.kicad_sch, part in row 2, column 2]

Parts:
C0: 22uF
C1, C2, C3, C4, C5, C6, C7, C8, C9, C10, C11, C12, C13, C14, C15, C16, C17, C18, C19, C20, C21, C22, C23, C24, C25, C26, C27, C28, C29, C30, C31, C32: 0.1uF
C41, C42, C43, C44: 1.0uF
J1, J4: CONN_2
J2, J3: CONN_3
P1: CONN_5X2
P2: CONN_10X2
P3: CONN_13X2
P4: CONN_20X2
P5, P6: CONN_4X2
P20: C96ABC
R1, R2, R3: 4700
RP1: 2200
RP2: 47K
SC1: 0.22F
U1: 74LS240
U2, U4: 74LS08
U3: NS32202
U5, U6, U8, U20: 74LS244
U7: DS1302
U9: 74LS688
U10: 74LS02
U11: 74LS04
U12: 74LS125
U13: 74LS139
U14: 74LS245
U15: 74LS157
U16: 74LS273
U17, U18, U19: 74LS153
U21: 74LS175
U22: 82C55
U27: 74LS32
U30: 16C550FN
U31: DIL14
U32: MAX232
U33: MAX235
X1: CRYSTAL
c40: 1.0uF

Connections:
/BOARD_SEL: U9.19 (P=R), U13.1 (E), U14.19 (CE), U30.16 (/CS2)
/CS_202: U2.1, U13.12 (O0)
/CS_CFG: U13.10 (O2), U27.1
/CS_PPI: U13.5 (O1), U22.6 (/CS)
/CS_RTC: U13.9 (O3), U27.5, U27.9
/CTS: P1.6, P6.5
/CTS/O: P2.5, P6.6
/CTS/R: P2.6, U32.8 (R2IN), U33.13 (R5IN)
/CTS/U: U30.40 (/CTS), U32.9 (R2OUT), U33.14 (R5OUT)
/DCD: P1.1, P2.13
/DCD/R: P2.14, U33.5 (R2IN)
/DCD/U: U30.42 (/DCD), U33.6 (R2OUT)
/DREQ: U8.7 (O1b), U12.12 (D)
/DSR: P1.2, P6.8
/DSR/O: P2.9, P6.7
/DSR/R: P2.10, U33.10 (R1IN)
/DSR/U: U30.41 (/DSR), U33.9 (R1OUT)
/DTR: P1.7, P6.4
/DTR/O: P2.12, P6.3
/DTR/R: P2.11, R1.2, U33.3 (T1OUT)
/DTR/U: U30.37 (/DTR), U33.8 (T1IN)
/IACTIVE: P4.39
/ICS0: P4.37, U11.6
/ICS1: P4.38, U10.13
/IDACK: P4.29
/INTA: J1.1, RP2.7, U11.1
/INTACK: U2.2, U2.5, U10.4, U20.1 (OEa), U20.19 (OEb)
/IORQ: U8.18 (O0a), U9.1 (G), U10.3
/IRD: P4.25, U11.12
/IRESET: P4.1, U11.8
/IWR: P4.23, U11.10
/M1: U2.10, U2.12, U4.2, U4.5, U4.10, U4.13, U8.16 (O1a), U9.17 (P7), U10.2
/OUT/CD/R: P2.15, R3.2, U33.4 (T2OUT)
/OUT/CD/U: U30.38 (/OUT1), U33.7 (T2IN)
/OUT/RI/R: P2.19, R2.2, U33.19 (T5OUT)
/OUT/RI/U: U30.35 (/OUT2), U33.22 (T5IN)
/PIC_CFG_WR: U16.11 (Cp), U27.3
/RD: U2.4, U8.14 (O2a), U14.1 (A->B), U22.5 (/RD), U27.10, U30.24 (/DISTR)
/RESET: U3.27 (/RST), U8.5 (O2b), U11.3, U16.1 (Mr), U21.1 (~Mr)
/RI: P1.8, P2.17
/RI/R: P2.18, U33.24 (R3IN)
/RI/U: U30.43 (/RI), U33.23 (R3OUT)
/RTC_RD: U12.10 (E), U12.13 (E), U27.8
/RTC_WR: U21.9 (Cp), U27.6
/RTS: P1.4, P6.1
/RTS/O: P2.8, P6.2
/RTS/R: P2.7, U32.7 (T2OUT), U33.2 (T3OUT)
/RTS/U: U30.36 (/RTS), U32.10 (T2IN), U33.15 (T3IN)
/WE_RTC: U12.4 (E), U21.6 (~Q1)
/WR: U3.31 (/WR), U8.12 (O3a), U22.36 (/WR), U27.2, U27.4, U30.20 (/DOSTR)
A0: U6.3 (O3b), U13.14 (A0), U22.9 (A0), U30.31 (A0)
A1: U6.5 (O2b), U13.13 (A1), U22.8 (A1), U30.30 (A1)
A2: U6.7 (O1b), U13.2 (A0), U30.29 (A2)
A3: U6.9 (O0b), U13.3 (A1), U30.14 (CS0), U30.15 (CS1)
A4: U6.12 (O3a), U9.8 (P3)
A5: U6.14 (O2a), U9.6 (P2)
A6: U6.16 (O1a), U9.4 (P1)
A7: U6.18 (O0a), U9.2 (P0)
A8: U2.9, U5.3 (O3b)
A9: U4.12, U5.5 (O2b)
A10: U4.9, U5.7 (O1b)
A11: U4.4, U5.9 (O0b)
A12: U4.1, U5.12 (O3a)
A13: U2.13, U5.14 (O2a)
BAI/O: P20.A12 (12A), P20.A17 (17A)
B_/DREQ: P20.B23 (23B), U8.13 (I1b)
B_/INT: P20.C21 (21C), RP1.10, U12.3 (O)
B_/INTA: P20.B25 (25B), U8.17 (I3b)
B_/IORQ: P20.A27 (27A), U8.2 (I0a)
B_/IRQ0: P20.B21 (21B), RP1.9, U1.2 (I0a)
B_/IRQ1: P20.B20 (20B), RP1.8, U1.4 (I1a)
B_/IRQ2: P20.B19 (19B), RP1.7, U1.6 (I2a)
B_/IRQ3: P20.B18 (18B), RP1.6, U1.8 (I3a)
B_/IRQ4: P20.B17 (17B), RP1.5, U1.11 (I0b)
B_/IRQ5: P20.B16 (16B), RP1.4, U1.13 (I1b)
B_/IRQ6: P20.B15 (15B), RP1.3, U1.15 (I2b)
B_/IRQ7: P20.B14 (14B), RP1.2, U1.17 (I3b)
B_/M1: P20.A20 (20A), U8.4 (I1a)
B_/RD: P20.C24 (24C), U8.6 (I2a)
B_/RESET: J2.1, P20.C31 (31C)
B_/RESOUT: J2.3, P20.C26 (26C)
B_/WR: P20.C22 (22C), U8.8 (I3a)
B_A0: P20.C5 (5C), U6.17 (I3b)
B_A1: P20.C7 (7C), U6.15 (I2b)
B_A2: P20.A6 (6A), U6.13 (I1b)
B_A3: P20.C6 (6C), U6.11 (I0b)
B_A4: P20.A7 (7A), U6.8 (I3a)
B_A5: P20.A8 (8A), U6.6 (I2a)
B_A6: P20.A9 (9A), U6.4 (I1a)
B_A7: P20.C9 (9C), U6.2 (I0a)
B_A8: P20.C8 (8C), U5.17 (I3b)
B_A9: P20.A30 (30A), U5.15 (I2b)
B_A10: P20.C18 (18C), U5.13 (I1b)
B_A11: P20.C17 (17C), U5.11 (I0b)
B_A12: P20.C27 (27C), U5.8 (I3a)
B_A13: P20.A29 (29A), U5.6 (I2a)
B_D0: P20.C2 (2C), U14.2 (A0), U20.3 (O3b)
B_D1: P20.C14 (14C), U14.9 (A7), U20.5 (O2b)
B_D2: P20.C4 (4C), U14.3 (A1), U20.7 (O1b)
B_D3: P20.A4 (4A), U14.4 (A2), U20.9 (O0b)
B_D4: P20.A5 (5A), U14.5 (A3), U20.12 (O3a)
B_D5: P20.A2 (2A), U14.6 (A4), U20.14 (O2a)
B_D6: P20.A3 (3A), U14.7 (A5), U20.16 (O1a)
B_D7: P20.C3 (3C), U14.8 (A6), U20.18 (O0a)
B_VBAT: J4.2 (PM), P20.A24 (24A)
CSEL: P4.2, P4.19, P4.22, P4.24, P4.26, P4.28, P4.30, P4.40
D0: U3.19 (D0), U12.8 (O), U14.18 (B0), U16.18 (D7), U18.3 (I3a), U18.12 (I2b), U19.5 (I1a), U19.10 (I0b), U21.4 (D0), U22.34 (D0), U30.2 (D0)
D1: U3.18 (D1), U14.11 (B7), U16.17 (D6), U17.13 (I3b), U18.4 (I2a), U18.11 (I1b), U19.6 (I0a), U21.5 (D1), U22.33 (D1), U30.3 (D1)
D2: U3.17 (D2), U14.17 (B1), U16.14 (D5), U17.3 (I3a), U17.12 (I2b), U18.5 (I1a), U18.10 (I0b), U21.12 (D2), U22.32 (D2), U30.4 (D2)
D3: U3.16 (D3), U14.16 (B2), U15.3 (I1a), U15.6 (I1b), U16.13 (D4), U21.13 (D3), U22.31 (D3), U30.5 (D3)
D4: U3.15 (D4), U14.15 (B3), U16.8 (D3), U22.30 (D4), U30.6 (D4)
D5: U3.14 (D5), U14.14 (B4), U16.7 (D2), U22.29 (D5), U30.7 (D5)
D6: U3.13 (D6), U14.13 (B5), U16.4 (D1), U22.28 (D6), U30.8 (D6)
D7: U3.12 (D7), U12.11 (O), U14.12 (B6), U16.3 (D0), U22.27 (D7), U30.9 (D7)
GND: C0.2, C1.2, C2.2, C3.2, C4.2, C5.2, C6.2, C7.2, C8.2, C9.2, C10.2, C11.2, C12.2, C13.2, C14.2, C15.2, C16.2, C17.2, C18.2, C19.2, C20.2, C21.2, C22.2, C23.2, C24.2, C25.2, C26.2, C27.2, C28.2, C29.2, C30.2, C31.2, C32.2, C42.1, J3.1, P1.9, P3.26 (P22), P5.1, P5.3, P5.5, P5.7, P20.A32 (32A), P20.B32 (32B), P20.C32 (32C), SC1.2, U1.1 (OEa), U1.19 (OEb), U5.1 (OEa), U5.19 (OEb), U6.1 (OEa), U6.19 (OEb), U7.4 (GND), U8.1 (OEa), U8.19 (OEb), U12.2 (D), U15.15 (E), U17.1 (Ea), U17.15 (Eb), U18.1 (Ea), U18.15 (Eb), U19.1 (Ea), U19.15 (Eb), U30.21 (DOSTR), U30.25 (DISTR), U30.28 (ADS), U31.4, U31.5, U31.6, U31.7, U32.15 (GND), U33.11 (GND), U33.20 (/ENR), U33.21 (SHDN), c40.2
HIGH: U3.1 (IR15), U3.4 (G7/IR14), U3.6 (G5/IR10), U3.7 (G4/IR8), U3.28 (/HBE), U3.37 (IR9), U3.38 (IR11), U3.39 (IR13), U15.14 (I0c)
IA0: P3.1, P4.35, U22.14 (PC0)
IA1: P3.3, P4.33, U22.15 (PC1)
IA2: P3.5, P4.36, U22.16 (PC2)
ID0: P3.2, P4.17, U22.4 (PA0)
ID1: P3.4, P4.15, U22.3 (PA1)
ID2: P3.6, P4.13, U22.2 (PA2)
ID3: P3.8, P4.11, U22.1 (PA3)
ID4: P3.10, P4.9, U22.40 (PA4)
ID5: P3.12, P4.7, U22.39 (PA5)
ID6: P3.14, P4.5, U22.38 (PA6)
ID7: P3.16, P4.3, U22.37 (PA7)
ID8: P3.18, P4.4, U22.18 (PB0)
ID9: P3.20, P4.6, U22.19 (PB1)
ID10: P3.22, P4.8, U22.20 (PB2)
ID11: P3.24 (P20), P4.10, U22.21 (PB3)
ID12: P3.23, P4.12, U22.22 (PB4)
ID13: P3.21, P4.14, U22.23 (PB5)
ID14: P3.19, P4.16, U22.24 (PB6)
ID15: P3.17, P4.18, U22.25 (PB7)
IDE_IRQ: P4.31
IDREQ: P4.21
IEI/O: P20.C11 (11C), P20.C16 (16C)
IID3V3: U15.4 (Za), U18.6 (I0a)
IID3V4: U15.7 (Zb), U17.11 (I1b)
INT_UART: U15.11 (I0d), U15.13 (I1c), U30.33 (IRQ)
IOCS16: P4.32
IORDY: P4.27
unnamed: C43.1, U32.1 (C1+)
unnamed: C43.2, U32.3 (C1-)
unnamed: C44.1, U32.4 (C2+)
unnamed: C44.2, U32.5 (C2-)
unnamed: J1.2 (PM), U8.3 (O3b)
unnamed: J2.2 (PM), U8.15 (I2b)
unnamed: J4.1, SC1.1, U7.8 (VBAT)
unnamed: P5.2, RP2.2, U9.3 (R0)
unnamed: P5.4, RP2.3, U9.5 (R1)
unnamed: P5.6, RP2.4, U9.7 (R2)
unnamed: P5.8, RP2.5, U9.9 (R3)
unnamed: RP2.6, U9.11 (P4), U9.12 (R4), U9.13 (P5), U9.14 (R5), U9.15 (P6), U9.16 (R6), U9.18 (R7)
unnamed: U1.3 (O3b), U3.36 (IR7)
unnamed: U1.5 (O2b), U3.8 (G3/IR6)
unnamed: U1.7 (O1b), U3.35 (IR5)
unnamed: U1.9 (O0b), U15.10 (I1d)
unnamed: U1.12 (O3a), U3.34 (IR3)
unnamed: U1.14 (O2a), U3.10 (G1/IR2)
unnamed: U1.16 (O1a), U3.33 (IR1)
unnamed: U1.18 (O0a), U3.11 (G0/IR0)
unnamed: U2.3, U3.21 (/CS)
unnamed: U2.6, U3.30 (/RD)
unnamed: U2.8, U3.22 (A0)
unnamed: U2.11, U3.3 (ST1)
unnamed: U3.23 (A1), U4.11
unnamed: U3.24 (A2), U4.8
unnamed: U3.25 (A3), U4.6
unnamed: U3.26 (A4), U4.3
unnamed: U7.2 (XTAL1), X1.1
unnamed: U7.3 (XTAL2), X1.2
unnamed: U10.6, U11.2
unnamed: U3.2 (/INT), U12.1 (E)
unnamed: U12.5 (D), U21.2 (Q0)
unnamed: U7.6 (DQ), U12.6 (O), U12.9 (D)
unnamed: U13.4 (O0), U13.15 (E)
unnamed: U3.9 (G2/IR4), U15.9 (Zd)
unnamed: U3.5 (G6/IR12), U15.12 (Zc)
unnamed: U16.16 (Q6), U17.2 (S1), U18.2 (S1), U19.2 (S1)
unnamed: U16.19 (Q7), U17.14 (S0), U18.14 (S0), U19.14 (S0)
unnamed: U17.7 (Za), U20.6 (I2a)
unnamed: U17.9 (Zb), U20.8 (I3a)
unnamed: U18.7 (Za), U20.11 (I0b)
unnamed: U18.9 (Zb), U20.13 (I1b)
unnamed: U19.7 (Za), U20.15 (I2b)
unnamed: U19.9 (Zb), U20.17 (I3b)
unnamed: U7.7 (SCLK), U21.10 (Q2)
unnamed: U7.5 (RST), U21.14 (~Q3)
unnamed: U30.10 (RCLK), U30.17 (BAUDOUT)
OPT16/8: U15.1 (S), U16.15 (Q5)
OSC-1.8432: U3.32 (CLK), U30.18 (XTAL1(I)), U31.8, U31.9, U31.10, U31.11
PC3: P3.7, U11.5, U22.17 (PC3)
PC4: P3.9, U10.11, U10.12, U22.13 (PC4)
PC5: P3.11, U11.11, U22.12 (PC5)
PC6: P3.13, U11.13, U22.11 (PC6)
PC7: P3.15, U11.9, U22.10 (PC7)
PDIAG: P4.34
PU-G0: RP2.8
PU-G1: RP2.9
PU-G2: RP2.10
PWR_GND: J3.2 (PM), P3.25 (P24), P4.20
RESET: U11.4, U22.35 (RESET), U30.39 (MR)
RXD: P1.3, P2.1
RXD/R: P2.2, U32.13 (R1IN), U33.18 (R4IN)
RXD/U: U30.11 (SIN), U32.12 (R1OUT), U33.17 (R4OUT)
TXD: P1.5, P2.4
TXD/R: P2.3, U32.14 (T1OUT), U33.1 (T4OUT)
TXD/U: U30.13 (SOUT), U32.11 (T1IN), U33.16 (T4IN)
VCC: C0.1, C1.1, C2.1, C3.1, C4.1, C5.1, C6.1, C7.1, C8.1, C9.1, C10.1, C11.1, C12.1, C13.1, C14.1, C15.1, C16.1, C17.1, C18.1, C19.1, C20.1, C21.1, C22.1, C23.1, C24.1, C25.1, C26.1, C27.1, C28.1, C29.1, C30.1, C31.1, C32.1, C41.2, J3.3, P20.A1 (1A), P20.B1 (1B), P20.C1 (1C), RP1.1 (COM), RP2.1 (COM), U7.1 (VCC), U31.14, U32.16 (VCC), U33.12 (VCC), c40.1
VEC3: U15.2 (I0a), U16.12 (Q4), U19.11 (I1b), U19.12 (I2b), U19.13 (I3b)
VEC4: U15.5 (I0b), U16.9 (Q3), U17.10 (I0b), U19.3 (I3a), U19.4 (I2a)
VEC5: U16.6 (Q2), U17.4 (I2a), U17.5 (I1a), U17.6 (I0a), U18.13 (I3b)
VEC6: U16.5 (Q1), U20.4 (I1a)
VEC7: U16.2 (Q0), U20.2 (I0a)
Vfalse: C41.1, R1.1, R3.1, U32.2 (V+)
Vtrue: C42.2, R2.1, U32.6 (V-)
Z80-INTA: U10.1, U10.5

Notes on the sheet:
CONFIGURATION REGISTER
During programmed operation, /M1 is high, and all 32 internal registers are accessible. A13 controls the ST1 input. During INTA, /M1 is low, all address bits are low, and ST1 is low. For EOI, read register 0 with A13=1.
UART personality jumpers: Terminal Modem 1-2 1-3 3-4 2-4 5-6 5-7 7-8 6-8 9-10 9-11 11-12 10-12 13-14 13-15 15-16 14-16 17-18 17-19 19-20 18-20
1.8432 Mhz
SUPER CAPACITOR
Using /INTA may be dangerous because /M1 is required by the NS32202 to zap the address lines on Z80-INTA.
rev. 007: R1, R3 -- pull up to V+, not V- R2 -- pull up to V-, not V+
rev. 007: Reset jumper 1-2 N8VEM legacy 2-3 Kontron compatible
Connect to VBAT only if SuperCap is not used.
UART auto-flow control select: RTS/CTS to RTS/CTS to RTS/CTS DTR/DSR 1-2 1-3 3-4 2-4 5-6 5-7 7-8 6-8
32.768KHZ tuning fork
Update 09/2011 -- able to read B_/DREQ:
