danwerner21/mini68k/hardware/sbc/CPU chip.kicad_sch

## KiCad design hardware/sbc/CPU chip.kicad_sch (2026-08-16)

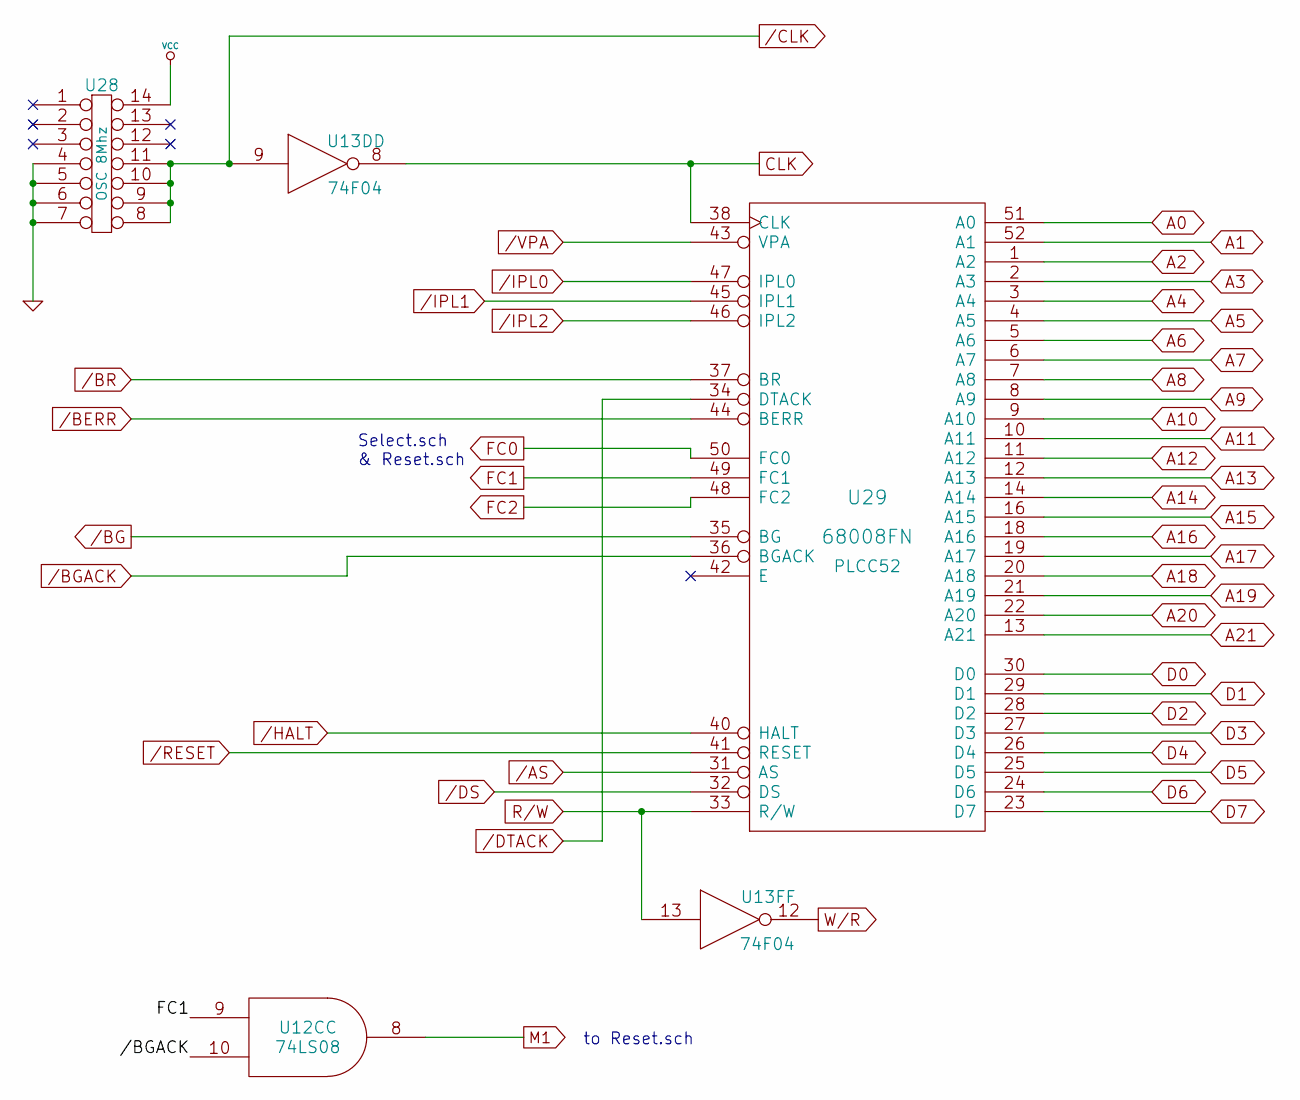
[picture p16: schematic CPU chip.kicad_sch]

Parts:
U12C: 74LS08
U13D, U13F: 74F04
U28: OSC 8Mhz
U29: 68008FN; PLCC52

Connections:
/AS: U29.31 (AS)
/BERR: U29.44 (BERR)
/BG: U29.35 (BG)
/BGACK: U12C.10, U29.36 (BGACK)
/BR: U29.37 (BR)
/CLK: U13D.9, U28.8, U28.9, U28.10, U28.11
/DS: U29.32 (DS)
/DTACK: U29.34 (DTACK)
/HALT: U29.40 (HALT)
/IPL0: U29.47 (IPL0)
/IPL1: U29.45 (IPL1)
/IPL2: U29.46 (IPL2)
/RESET: U29.41 (RESET)
/VPA: U29.43 (VPA)
A0: U29.51 (A0)
A1: U29.52 (A1)
A2: U29.1 (A2)
A3: U29.2 (A3)
A4: U29.3 (A4)
A5: U29.4 (A5)
A6: U29.5 (A6)
A7: U29.6 (A7)
A8: U29.7 (A8)
A9: U29.8 (A9)
A10: U29.9 (A10)
A11: U29.10 (A11)
A12: U29.11 (A12)
A13: U29.12 (A13)
A14: U29.14 (A14)
A15: U29.16 (A15)
A16: U29.18 (A16)
A17: U29.19 (A17)
A18: U29.20 (A18)
A19: U29.21 (A19)
A20: U29.22 (A20)
A21: U29.13 (A21)
CLK: U13D.8, U29.38 (CLK)
D0: U29.30 (D0)
D1: U29.29 (D1)
D2: U29.28 (D2)
D3: U29.27 (D3)
D4: U29.26 (D4)
D5: U29.25 (D5)
D6: U29.24 (D6)
D7: U29.23 (D7)
FC0: U29.50 (FC0)
FC1: U12C.9, U29.49 (FC1)
FC2: U29.48 (FC2)
GND: U28.4, U28.5, U28.6, U28.7
M1: U12C.8
R/W: U13F.13, U29.33 (R/W)
VCC: U28.14
W/R: U13F.12

Notes on the sheet:
Select.sch & Reset.sch
to Reset.sch
