danwerner21/mini68k/hardware/sbc/ECBbus.kicad_sch

## KiCad design hardware/sbc/ECBbus.kicad_sch (2026-08-16)

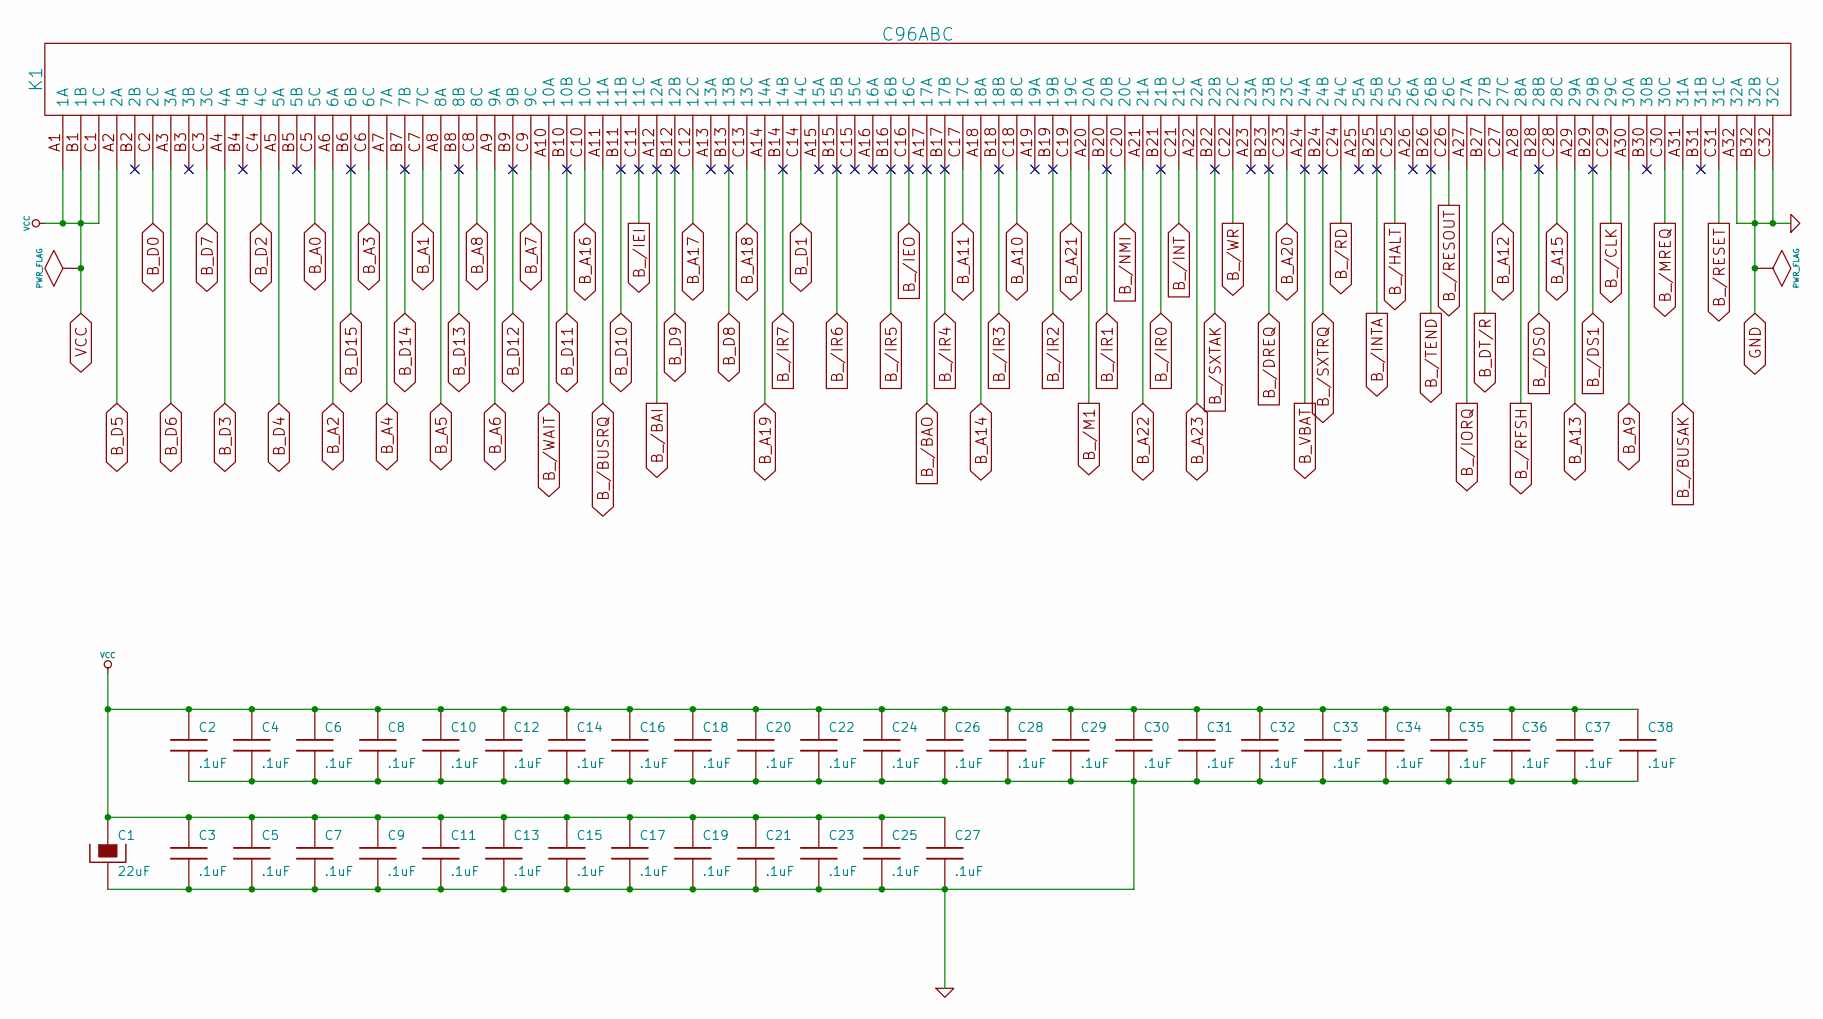
[picture p17: schematic ECBbus.kicad_sch]

Parts:
C1: 22uF
C2, C3, C4, C5, C6, C7, C8, C9, C10, C11, C12, C13, C14, C15, C16, C17, C18, C19, C20, C21, C22, C23, C24, C25, C26, C27, C28, C29, C30, C31, C32, C33, C34, C35, C36, C37, C38: .1uF
K1: C96ABC

Connections:
B_/BAI: K1.A12 (12A)
B_/BAO: K1.A17 (17A)
B_/BUSAK: K1.A31 (31A)
B_/BUSRQ: K1.A11 (11A)
B_/CLK: K1.C29 (29C)
B_/DREQ: K1.B23 (23B)
B_/DS0: K1.B28 (28B)
B_/DS1: K1.B29 (29B)
B_/HALT: K1.C25 (25C)
B_/IEI: K1.C11 (11C)
B_/IEO: K1.C16 (16C)
B_/INT: K1.C21 (21C)
B_/INTA: K1.B25 (25B)
B_/IORQ: K1.A27 (27A)
B_/IR0: K1.B21 (21B)
B_/IR1: K1.B20 (20B)
B_/IR2: K1.B19 (19B)
B_/IR3: K1.B18 (18B)
B_/IR4: K1.B17 (17B)
B_/IR5: K1.B16 (16B)
B_/IR6: K1.B15 (15B)
B_/IR7: K1.B14 (14B)
B_/M1: K1.A20 (20A)
B_/MREQ: K1.C30 (30C)
B_/NMI: K1.C20 (20C)
B_/RD: K1.C24 (24C)
B_/RESET: K1.C31 (31C)
B_/RESOUT: K1.C26 (26C)
B_/RFSH: K1.A28 (28A)
B_/SXTAK: K1.B22 (22B)
B_/SXTRQ: K1.B24 (24B)
B_/TEND: K1.B26 (26B)
B_/WAIT: K1.A10 (10A)
B_/WR: K1.C22 (22C)
B_A0: K1.C5 (5C)
B_A1: K1.C7 (7C)
B_A2: K1.A6 (6A)
B_A3: K1.C6 (6C)
B_A4: K1.A7 (7A)
B_A5: K1.A8 (8A)
B_A6: K1.A9 (9A)
B_A7: K1.C9 (9C)
B_A8: K1.C8 (8C)
B_A9: K1.A30 (30A)
B_A10: K1.C18 (18C)
B_A11: K1.C17 (17C)
B_A12: K1.C27 (27C)
B_A13: K1.A29 (29A)
B_A14: K1.A18 (18A)
B_A15: K1.C28 (28C)
B_A16: K1.C10 (10C)
B_A17: K1.C12 (12C)
B_A18: K1.C13 (13C)
B_A19: K1.A14 (14A)
B_A20: K1.C23 (23C)
B_A21: K1.C19 (19C)
B_A22: K1.A21 (21A)
B_A23: K1.A22 (22A)
B_D0: K1.C2 (2C)
B_D1: K1.C14 (14C)
B_D2: K1.C4 (4C)
B_D3: K1.A4 (4A)
B_D4: K1.A5 (5A)
B_D5: K1.A2 (2A)
B_D6: K1.A3 (3A)
B_D7: K1.C3 (3C)
B_D8: K1.B13 (13B)
B_D9: K1.B12 (12B)
B_D10: K1.B11 (11B)
B_D11: K1.B10 (10B)
B_D12: K1.B9 (9B)
B_D13: K1.B8 (8B)
B_D14: K1.B7 (7B)
B_D15: K1.B6 (6B)
B_DT/R: K1.B27 (27B)
B_VBAT: K1.A24 (24A)
GND: C1.2, C2.2, C3.2, C4.2, C5.2, C6.2, C7.2, C8.2, C9.2, C10.2, C11.2, C12.2, C13.2, C14.2, C15.2, C16.2, C17.2, C18.2, C19.2, C20.2, C21.2, C22.2, C23.2, C24.2, C25.2, C26.2, C27.2, C28.2, C29.2, C30.2, C31.2, C32.2, C33.2, C34.2, C35.2, C36.2, C37.2, C38.2, K1.A32 (32A), K1.B32 (32B), K1.C32 (32C)
VCC: C1.1, C2.1, C3.1, C4.1, C5.1, C6.1, C7.1, C8.1, C9.1, C10.1, C11.1, C12.1, C13.1, C14.1, C15.1, C16.1, C17.1, C18.1, C19.1, C20.1, C21.1, C22.1, C23.1, C24.1, C25.1, C26.1, C27.1, C28.1, C29.1, C30.1, C31.1, C32.1, C33.1, C34.1, C35.1, C36.1, C37.1, C38.1, K1.A1 (1A), K1.B1 (1B), K1.C1 (1C)
