danwerner21/mini68k/hardware/sbc/babyM68K.kicad_sch

## KiCad design hardware/sbc/babyM68K.kicad_sch (2026-08-16)

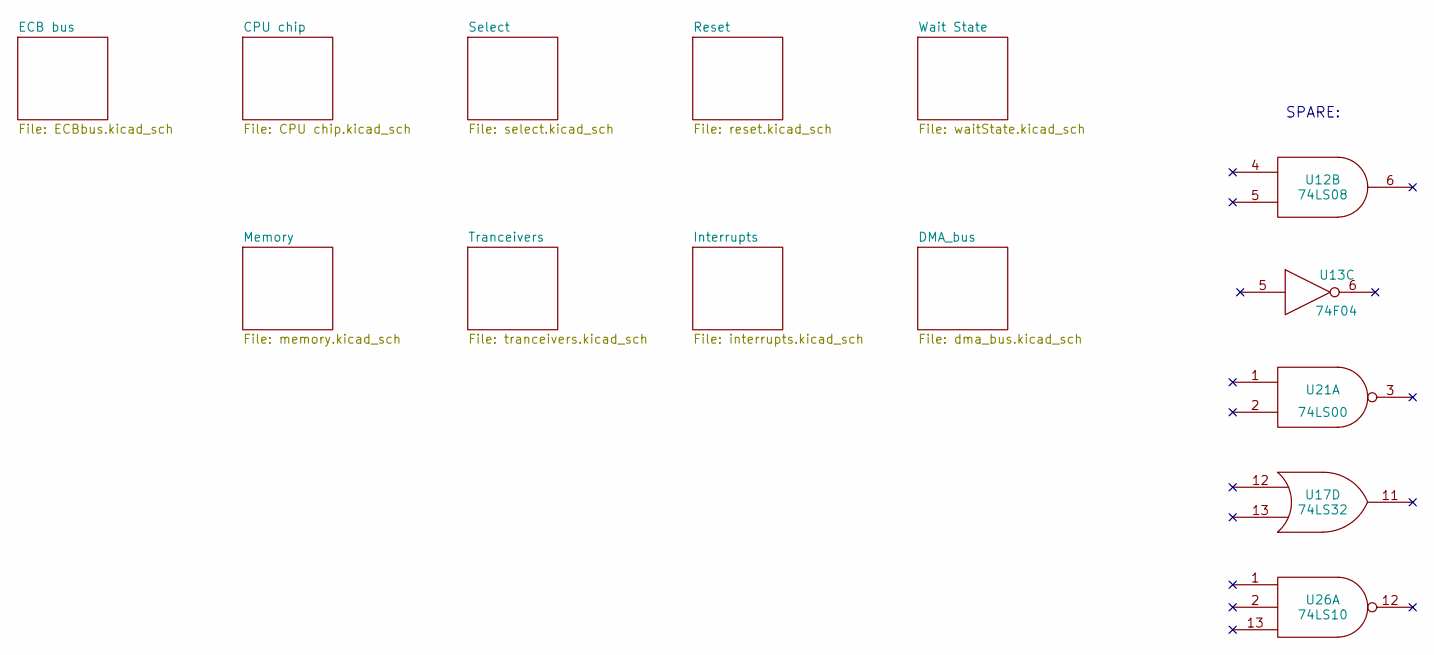
[picture p18: schematic babyM68K.kicad_sch]

Parts:
U12: 74LS08
U13: 74F04
U17: 74LS32
U21: 74LS00
U26: 74LS10

Notes on the sheet:
SPARE:
