danwerner21/mini68k/hardware/sbc/dma_bus.kicad_sch

## KiCad design hardware/sbc/dma_bus.kicad_sch (2026-08-16)

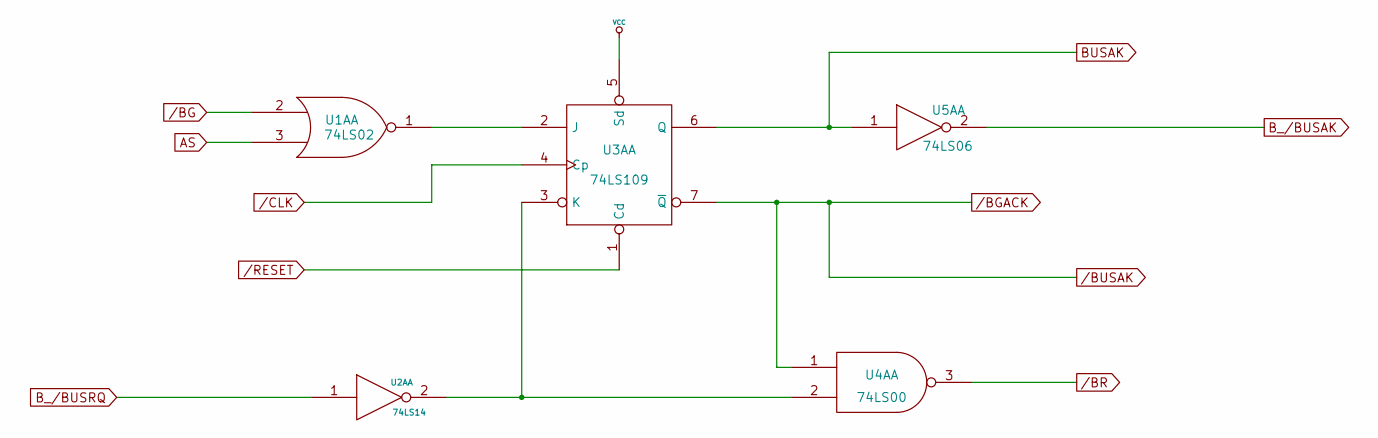
[picture p19: schematic dma_bus.kicad_sch]

Parts:
U1A: 74LS02
U2A: 74LS14
U3A: 74LS109
U4A: 74LS00
U5A: 74LS06

Connections:
/BG: U1A.2
/BGACK: U3A.7 (~Q), U4A.1
/BR: U4A.3
/CLK: U3A.4 (Cp)
/RESET: U3A.1 (Cd)
AS: U1A.3
BUSAK: U3A.6 (Q), U5A.1
B_/BUSAK: U5A.2
B_/BUSRQ: U2A.1
unnamed: U1A.1, U3A.2 (J)
unnamed: U2A.2, U3A.3 (K), U4A.2
VCC: U3A.5 (Sd)
