danwerner21/mini68k/hardware/sbc/interrupts.kicad_sch

## KiCad design hardware/sbc/interrupts.kicad_sch (2026-08-16)

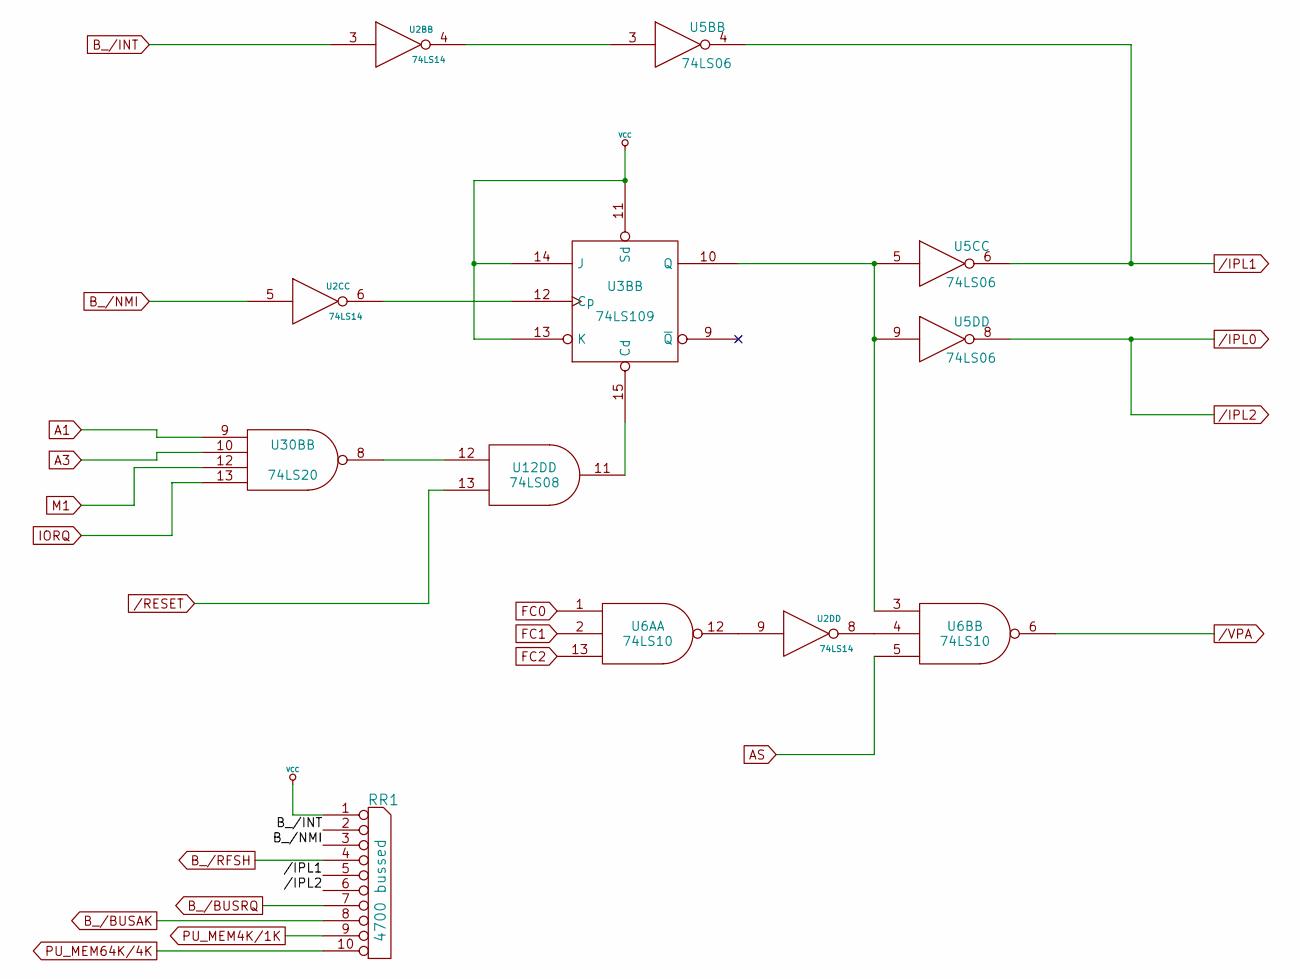
[picture p20: schematic interrupts.kicad_sch]

Parts:
RR1: 4700 bussed
U2B, U2C, U2D: 74LS14
U3B: 74LS109
U5B, U5C, U5D: 74LS06
U6A, U6B: 74LS10
U12D: 74LS08
U30B: 74LS20

Connections:
/IPL0: U5D.8
/IPL1: RR1.5, U5B.4, U5C.6
/IPL2: RR1.6
/RESET: U12D.13
/VPA: U6B.6
A1: U30B.9
A3: U30B.10
AS: U6B.5
B_/BUSAK: RR1.8
B_/BUSRQ: RR1.7
B_/INT: RR1.2, U2B.3
B_/NMI: RR1.3, U2C.5
B_/RFSH: RR1.4
FC0: U6A.1
FC1: U6A.2
FC2: U6A.13
IORQ: U30B.13
M1: U30B.12
unnamed: U2B.4, U5B.3
unnamed: U2C.6, U3B.12 (Cp)
unnamed: U2D.8, U6B.4
unnamed: U2D.9, U6A.12
unnamed: U3B.10 (Q), U5C.5, U5D.9, U6B.3
unnamed: U3B.15 (Cd), U12D.11
unnamed: U12D.12, U30B.8
PU_MEM4K/1K: RR1.9
PU_MEM64K/4K: RR1.10
VCC: RR1.1 (COM), U3B.11 (Sd), U3B.13 (K), U3B.14 (J)
