danwerner21/mini68k/hardware/sbc/reset.kicad_sch

## KiCad design hardware/sbc/reset.kicad_sch (2026-08-16)

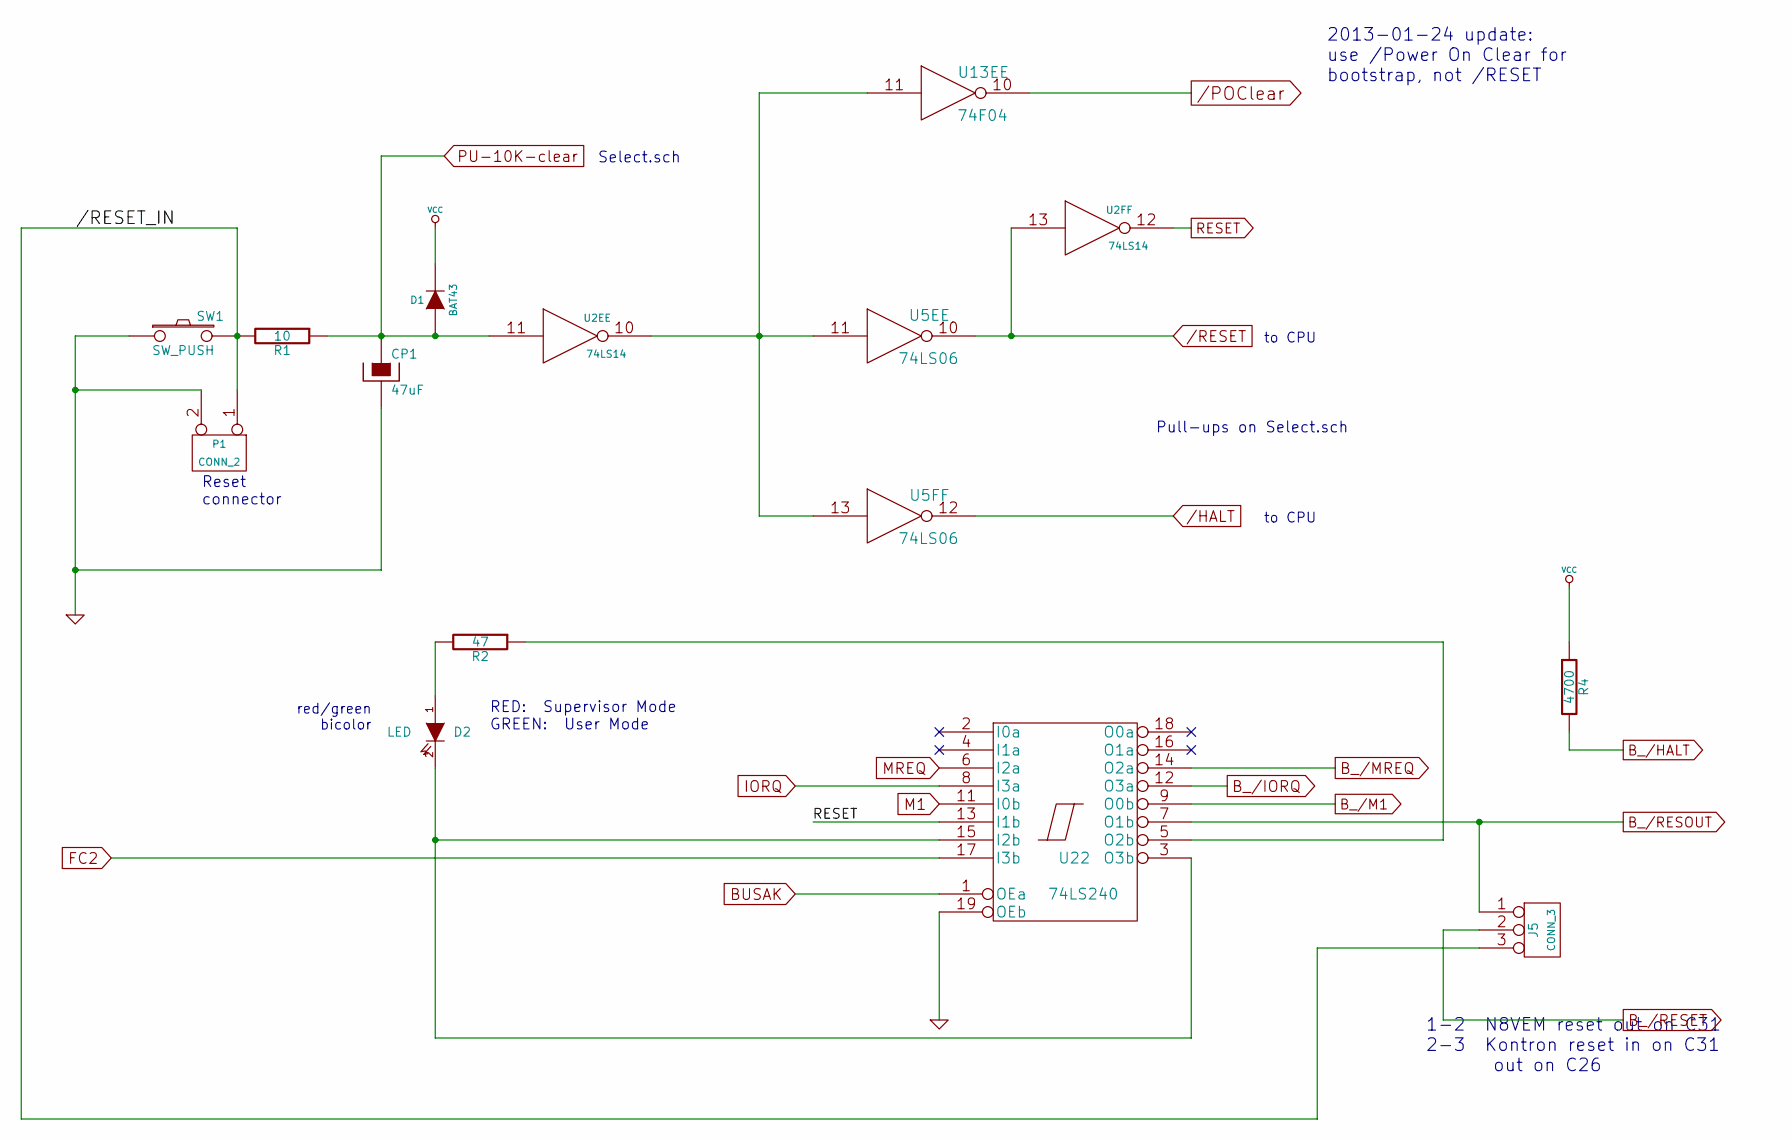
[picture p22: schematic reset.kicad_sch]

Parts:
CP1: 47uF
D1: BAT43
D2: LED
J5: CONN_3
P1: CONN_2
R1: 10
R2: 47
R4: 4700
SW1: SW_PUSH
U2E, U2F: 74LS14
U5E, U5F: 74LS06
U13E: 74F04
U22: 74LS240

Connections:
/HALT: U5F.12
/POClear: U13E.10
/RESET: U2F.13, U5E.10
/RESET_IN: J5.3, P1.1, R1.2, SW1.2
BUSAK: U22.1 (OEa)
B_/HALT: R4.2
B_/IORQ: U22.12 (O3a)
B_/M1: U22.9 (O0b)
B_/MREQ: U22.14 (O2a)
B_/RESET: J5.2 (PM)
B_/RESOUT: J5.1, U22.7 (O1b)
FC2: U22.17 (I3b)
GND: CP1.2, P1.2 (PM), SW1.1, U22.19 (OEb)
IORQ: U22.8 (I3a)
M1: U22.11 (I0b)
MREQ: U22.6 (I2a)
unnamed: D2.1 (A), R2.2
unnamed: D2.2 (K), U22.3 (O3b), U22.15 (I2b)
unnamed: R2.1, U22.5 (O2b)
unnamed: U2E.10, U5E.11, U5F.13, U13E.11
PU-10K-clear: CP1.1, D1.1 (A), R1.1, U2E.11
RESET: U2F.12, U22.13 (I1b)
VCC: D1.2 (K), R4.1

Notes on the sheet:
RED: Supervisor Mode GREEN: User Mode
Pull-ups on Select.sch
Select.sch
to CPU
red/green bicolor
2013-01-24 update: use /Power On Clear for bootstrap, not /RESET
Reset connector
1-2 N8VEM reset out on C31 2-3 Kontron reset in on C31 out on C26
