danwerner21/mini68k/hardware/sbc/rescue-backup/dma_bus-2026-08-16-14-59-02.sch

## KiCad design hardware/sbc/rescue-backup/dma_bus-2026-08-16-14-59-02.sch (2026-08-16)

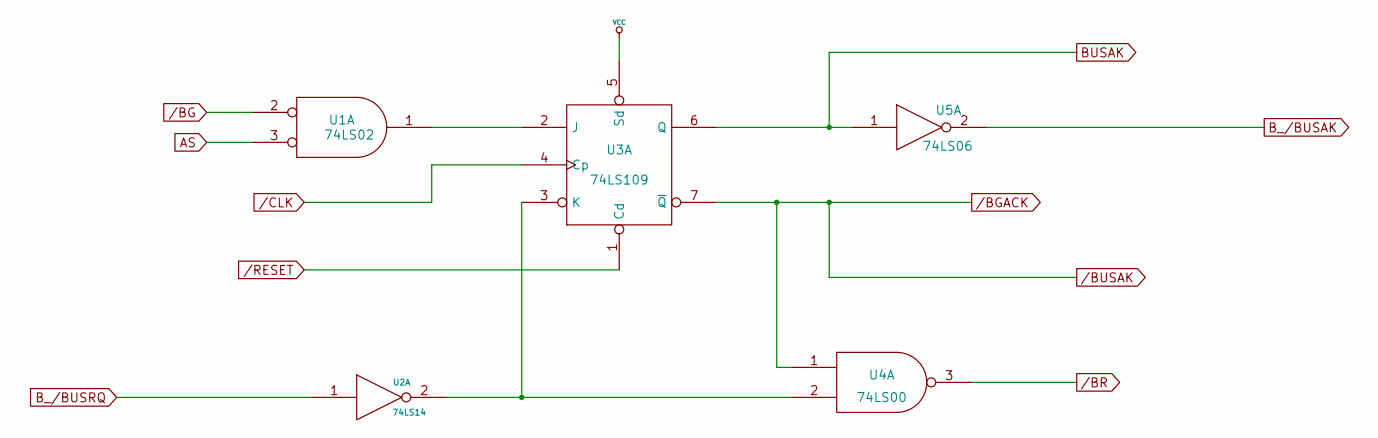
[picture p27: schematic dma_bus-2026-08-16-14-59-02.sch]

Parts:
U1: 74LS02
U2: 74LS14
U3: 74LS109
U4: 74LS00
U5: 74LS06

Connections:
/BG: U1.2
/BGACK: U3.7 (~Q), U4.1
/BR: U4.3
/CLK: U3.4 (Cp)
/RESET: U3.1 (Cd)
AS: U1.3
BUSAK: U3.6 (Q), U5.1
B_/BUSAK: U5.2
B_/BUSRQ: U2.1
unnamed: U1.1, U3.2 (J)
unnamed: U2.2, U3.3 (K), U4.2
VCC: U3.5 (Sd)
