danwerner21/mini68k/hardware/sbc/rescue-backup/interrupts-2026-08-16-14-59-02.sch

## KiCad design hardware/sbc/rescue-backup/interrupts-2026-08-16-14-59-02.sch (2026-08-16)

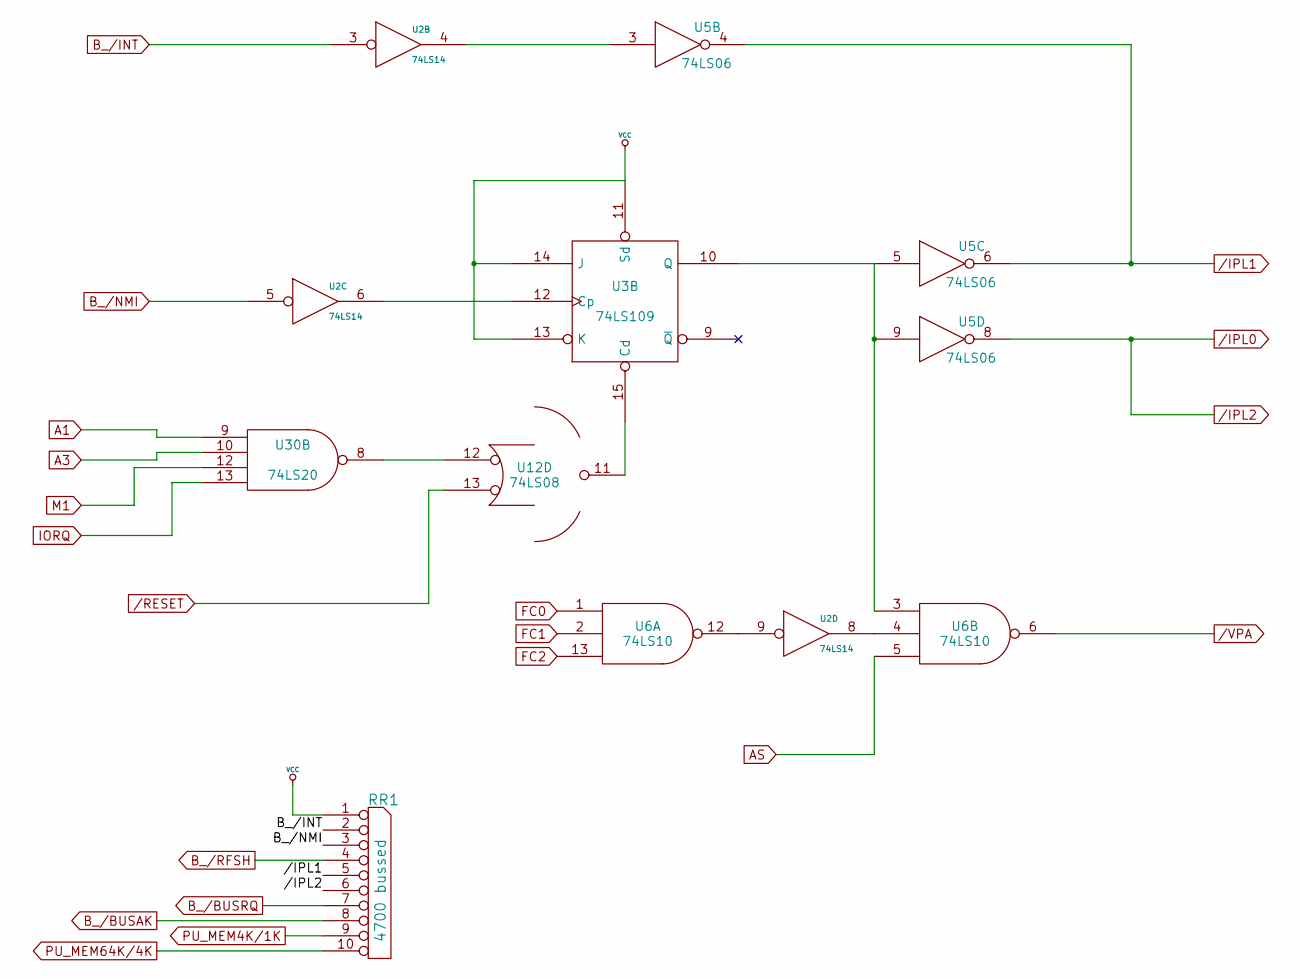
[picture p28: schematic interrupts-2026-08-16-14-59-02.sch]

Parts:
RR1: 4700 bussed
U2: 74LS14
U3: 74LS109
U5: 74LS06
U6: 74LS10
U12: 74LS08
U30: 74LS20

Connections:
/IPL0: U5.8
/IPL1: RR1.5, U5.4, U5.6
/IPL2: RR1.6
/RESET: U12.13
/VPA: U6.6
A1: U30.9
A3: U30.10
AS: U6.5
B_/BUSAK: RR1.8
B_/BUSRQ: RR1.7
B_/INT: RR1.2, U2.3
B_/NMI: RR1.3, U2.5
B_/RFSH: RR1.4
FC0: U6.1
FC1: U6.2
FC2: U6.13
IORQ: U30.13
M1: U30.12
unnamed: U2.4, U5.3
unnamed: U2.6, U3.12 (Cp)
unnamed: U2.8, U6.4
unnamed: U2.9, U6.12
unnamed: U3.10 (Q), U5.5, U5.9, U6.3
unnamed: U3.15 (Cd), U12.11
unnamed: U12.12, U30.8
PU_MEM4K/1K: RR1.9
PU_MEM64K/4K: RR1.10
VCC: RR1.1 (COM), U3.11 (Sd), U3.13 (K), U3.14 (J)
