danwerner21/mini68k/hardware/sbc/rescue-backup/memory-2026-08-16-14-59-02.sch

## KiCad design hardware/sbc/rescue-backup/memory-2026-08-16-14-59-02.sch (2026-08-16)

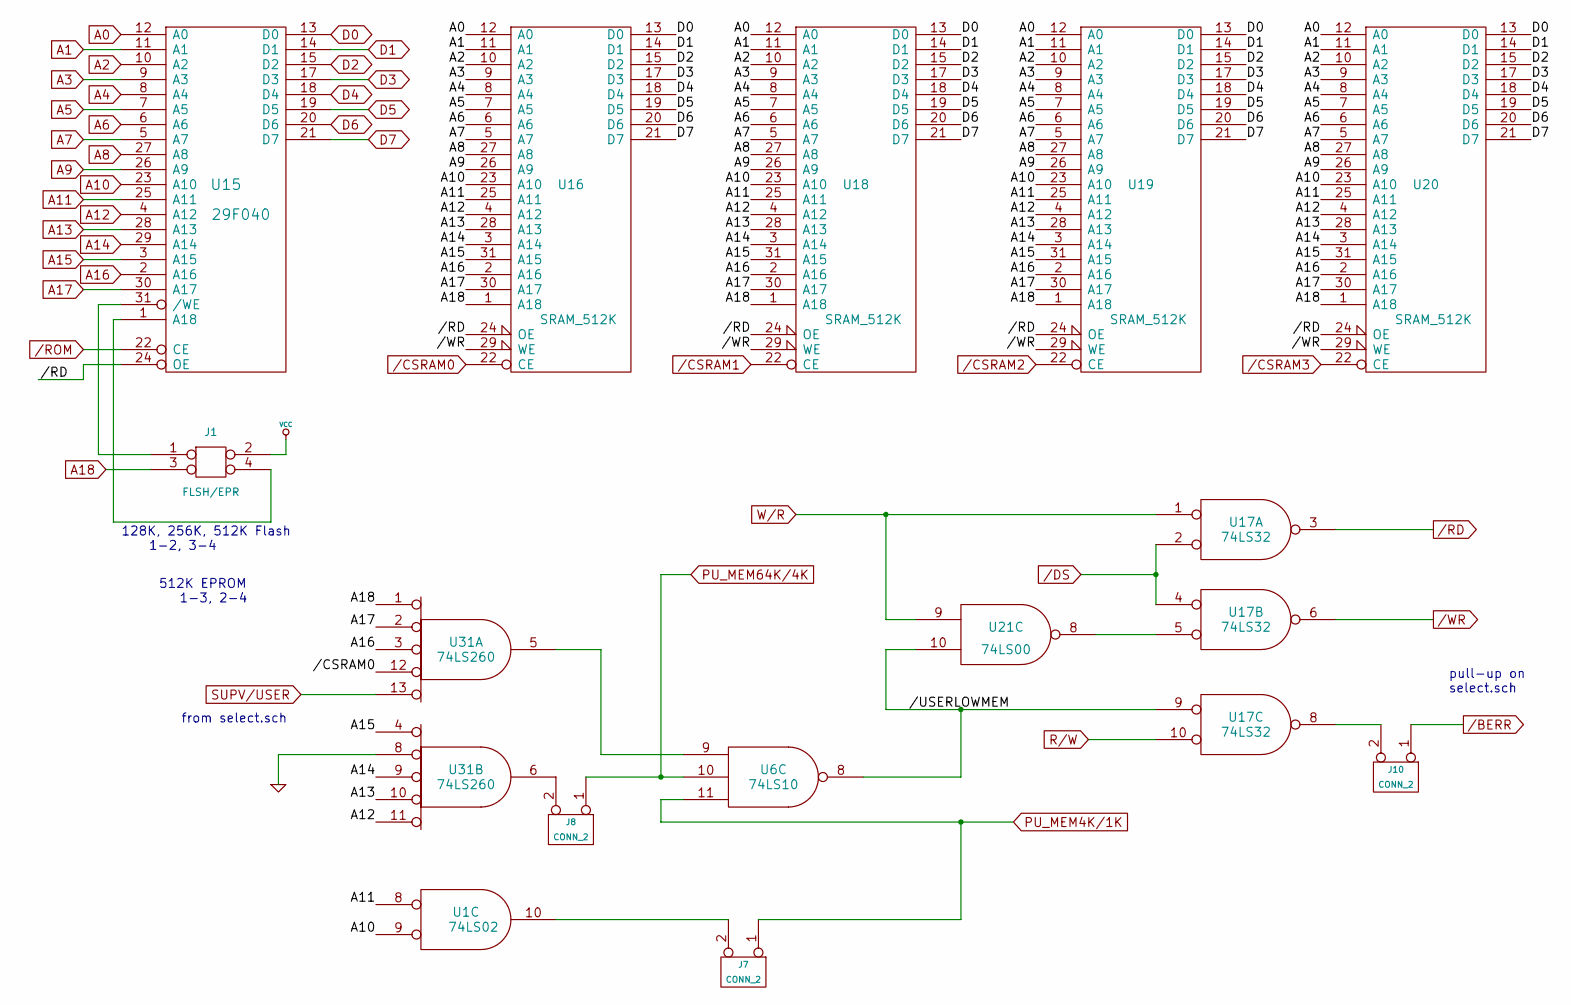
[picture p29: schematic memory-2026-08-16-14-59-02.sch]

Parts:
J1: FLSH/EPR
J7, J8, J10: CONN_2
U1: 74LS02
U6: 74LS10
U15: 29F040
U16, U18, U19, U20: SRAM_512K
U17: 74LS32
U21: 74LS00
U31: 74LS260

Connections:
/BERR: J10.1
/CSRAM0: U16.22 (CE), U31.12
/CSRAM1: U18.22 (CE)
/CSRAM2: U19.22 (CE)
/CSRAM3: U20.22 (CE)
/DS: U17.2, U17.4
/RD: U15.24 (OE), U16.24 (OE), U17.3, U18.24 (OE), U19.24 (OE), U20.24 (OE)
/ROM: U15.22 (CE)
/USERLOWMEM: U6.8, U17.9, U21.10
/WR: U16.29 (WE), U17.6, U18.29 (WE), U19.29 (WE), U20.29 (WE)
A0: U15.12 (A0), U16.12 (A0), U18.12 (A0), U19.12 (A0), U20.12 (A0)
A1: U15.11 (A1), U16.11 (A1), U18.11 (A1), U19.11 (A1), U20.11 (A1)
A2: U15.10 (A2), U16.10 (A2), U18.10 (A2), U19.10 (A2), U20.10 (A2)
A3: U15.9 (A3), U16.9 (A3), U18.9 (A3), U19.9 (A3), U20.9 (A3)
A4: U15.8 (A4), U16.8 (A4), U18.8 (A4), U19.8 (A4), U20.8 (A4)
A5: U15.7 (A5), U16.7 (A5), U18.7 (A5), U19.7 (A5), U20.7 (A5)
A6: U15.6 (A6), U16.6 (A6), U18.6 (A6), U19.6 (A6), U20.6 (A6)
A7: U15.5 (A7), U16.5 (A7), U18.5 (A7), U19.5 (A7), U20.5 (A7)
A8: U15.27 (A8), U16.27 (A8), U18.27 (A8), U19.27 (A8), U20.27 (A8)
A9: U15.26 (A9), U16.26 (A9), U18.26 (A9), U19.26 (A9), U20.26 (A9)
A10: U1.9, U15.23 (A10), U16.23 (A10), U18.23 (A10), U19.23 (A10), U20.23 (A10)
A11: U1.8, U15.25 (A11), U16.25 (A11), U18.25 (A11), U19.25 (A11), U20.25 (A11)
A12: U15.4 (A12), U16.4 (A12), U18.4 (A12), U19.4 (A12), U20.4 (A12), U31.11
A13: U15.28 (A13), U16.28 (A13), U18.28 (A13), U19.28 (A13), U20.28 (A13), U31.10
A14: U15.29 (A14), U16.3 (A14), U18.3 (A14), U19.3 (A14), U20.3 (A14), U31.9
A15: U15.3 (A15), U16.31 (A15), U18.31 (A15), U19.31 (A15), U20.31 (A15), U31.4
A16: U15.2 (A16), U16.2 (A16), U18.2 (A16), U19.2 (A16), U20.2 (A16), U31.3
A17: U15.30 (A17), U16.30 (A17), U18.30 (A17), U19.30 (A17), U20.30 (A17), U31.2
A18: J1.3, U16.1 (A18), U18.1 (A18), U19.1 (A18), U20.1 (A18), U31.1
D0: U15.13 (D0), U16.13 (D0), U18.13 (D0), U19.13 (D0), U20.13 (D0)
D1: U15.14 (D1), U16.14 (D1), U18.14 (D1), U19.14 (D1), U20.14 (D1)
D2: U15.15 (D2), U16.15 (D2), U18.15 (D2), U19.15 (D2), U20.15 (D2)
D3: U15.17 (D3), U16.17 (D3), U18.17 (D3), U19.17 (D3), U20.17 (D3)
D4: U15.18 (D4), U16.18 (D4), U18.18 (D4), U19.18 (D4), U20.18 (D4)
D5: U15.19 (D5), U16.19 (D5), U18.19 (D5), U19.19 (D5), U20.19 (D5)
D6: U15.20 (D6), U16.20 (D6), U18.20 (D6), U19.20 (D6), U20.20 (D6)
D7: U15.21 (D7), U16.21 (D7), U18.21 (D7), U19.21 (D7), U20.21 (D7)
GND: U31.8
unnamed: J1.1, U15.31 (/WE)
unnamed: J1.4, U15.1 (A18)
unnamed: J7.2 (PM), U1.10
unnamed: J8.2 (PM), U31.6
unnamed: J10.2 (PM), U17.8
unnamed: U17.5, U21.8
unnamed: U6.9, U31.5
PU_MEM4K/1K: J7.1, U6.11
PU_MEM64K/4K: J8.1, U6.10
R/W: U17.10
SUPV/USER: U31.13
VCC: J1.2
W/R: U17.1, U21.9

Notes on the sheet:
from select.sch
pull-up on select.sch
128K, 256K, 512K Flash 1-2, 3-4
512K EPROM 1-3, 2-4
