danwerner21/mini68k/hardware/sbc/rescue-backup/select-2026-08-16-14-59-02.sch

## KiCad design hardware/sbc/rescue-backup/select-2026-08-16-14-59-02.sch (2026-08-16)

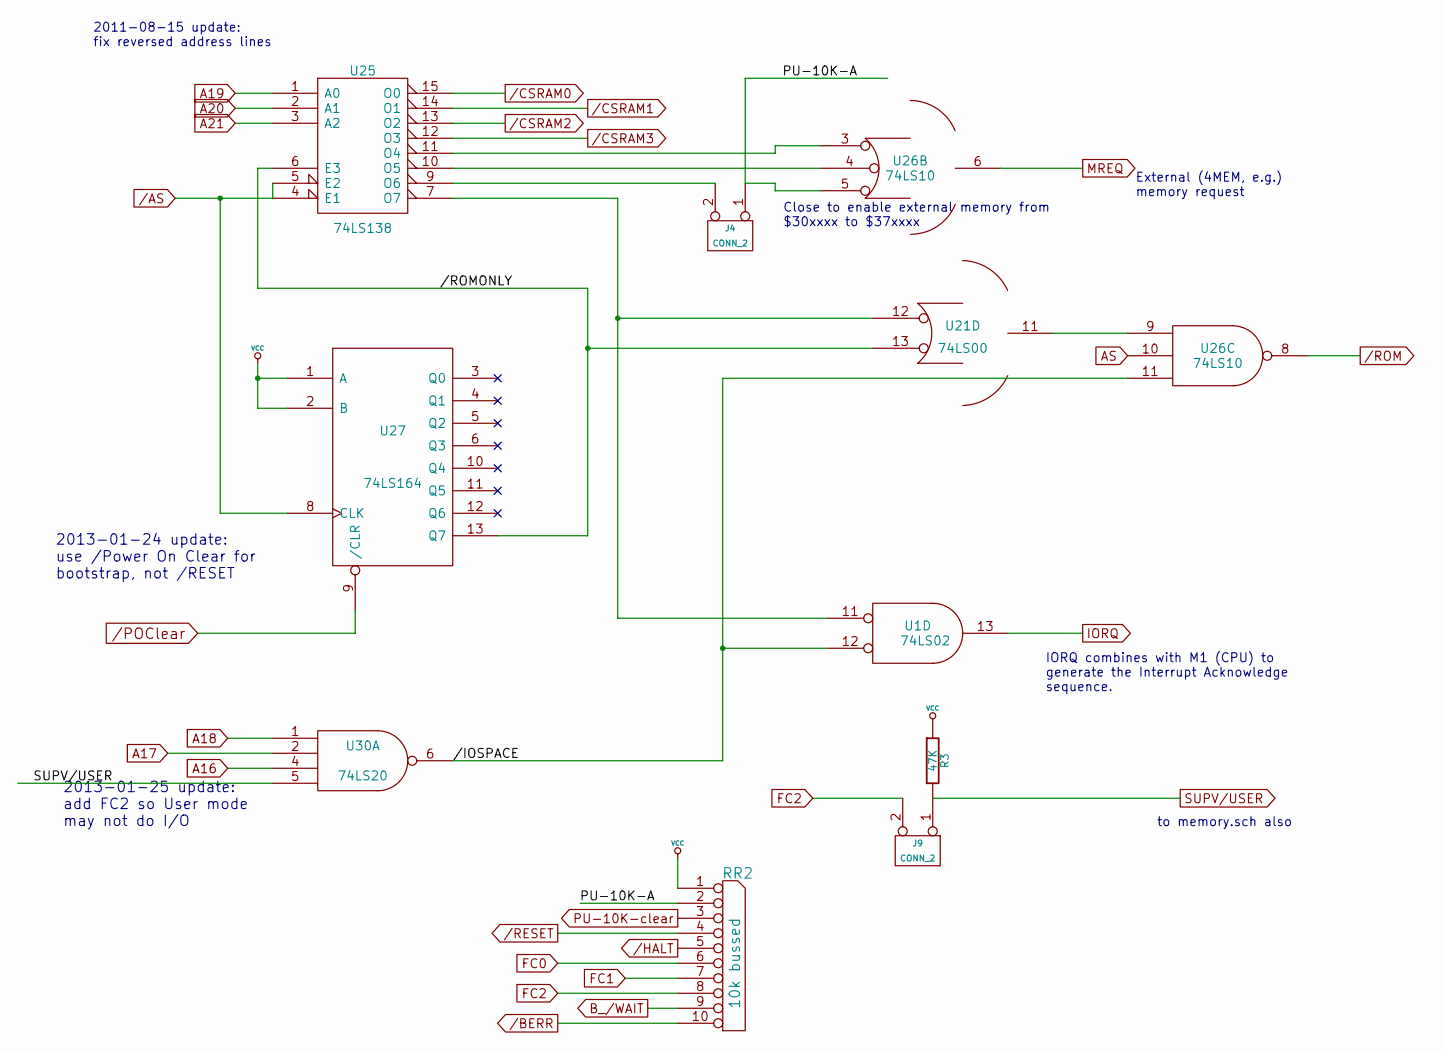
[picture p31: schematic select-2026-08-16-14-59-02.sch]

Parts:
J4, J9: CONN_2
R3: 47K
RR2: 10k bussed
U1: 74LS02
U21: 74LS00
U25: 74LS138
U26: 74LS10
U27: 74LS164
U30: 74LS20

Connections:
/AS: U25.4 (E1), U25.5 (E2), U27.8 (CLK)
/BERR: RR2.10
/CSRAM0: U25.15 (O0)
/CSRAM1: U25.14 (O1)
/CSRAM2: U25.13 (O2)
/CSRAM3: U25.12 (O3)
/HALT: RR2.5
/IOSPACE: U1.12, U26.11, U30.6
/POClear: U27.9 (/CLR)
/RESET: RR2.4
/ROM: U26.8
/ROMONLY: U21.13, U25.6 (E3), U27.13 (Q7)
A16: U30.4
A17: U30.2
A18: U30.1
A19: U25.1 (A0)
A20: U25.2 (A1)
A21: U25.3 (A2)
AS: U26.10
B_/WAIT: RR2.9
FC0: RR2.6
FC1: RR2.7
FC2: J9.2 (PM), RR2.8
IORQ: U1.13
MREQ: U26.6
unnamed: J4.2 (PM), U25.9 (O6)
unnamed: U1.11, U21.12, U25.7 (O7)
unnamed: U21.11, U26.9
unnamed: U25.10 (O5), U26.4
unnamed: U25.11 (O4), U26.3
PU-10K-A: J4.1, RR2.2, U26.5
PU-10K-clear: RR2.3
SUPV/USER: J9.1, R3.2, U30.5
VCC: R3.1, RR2.1 (COM), U27.1 (A), U27.2 (B)

Notes on the sheet:
to memory.sch also
2013-01-25 update: add FC2 so User mode may not do I/O
2013-01-24 update: use /Power On Clear for bootstrap, not /RESET
2011-08-15 update: fix reversed address lines
External (4MEM, e.g.) memory request
Close to enable external memory from $30xxxx to $37xxxx
IORQ combines with M1 (CPU) to generate the Interrupt Acknowledge sequence.
