danwerner21/mini68k/hardware/sbc/rescue-backup/tranceivers-2026-08-16-14-59-02.sch

## KiCad design hardware/sbc/rescue-backup/tranceivers-2026-08-16-14-59-02.sch (2026-08-16)

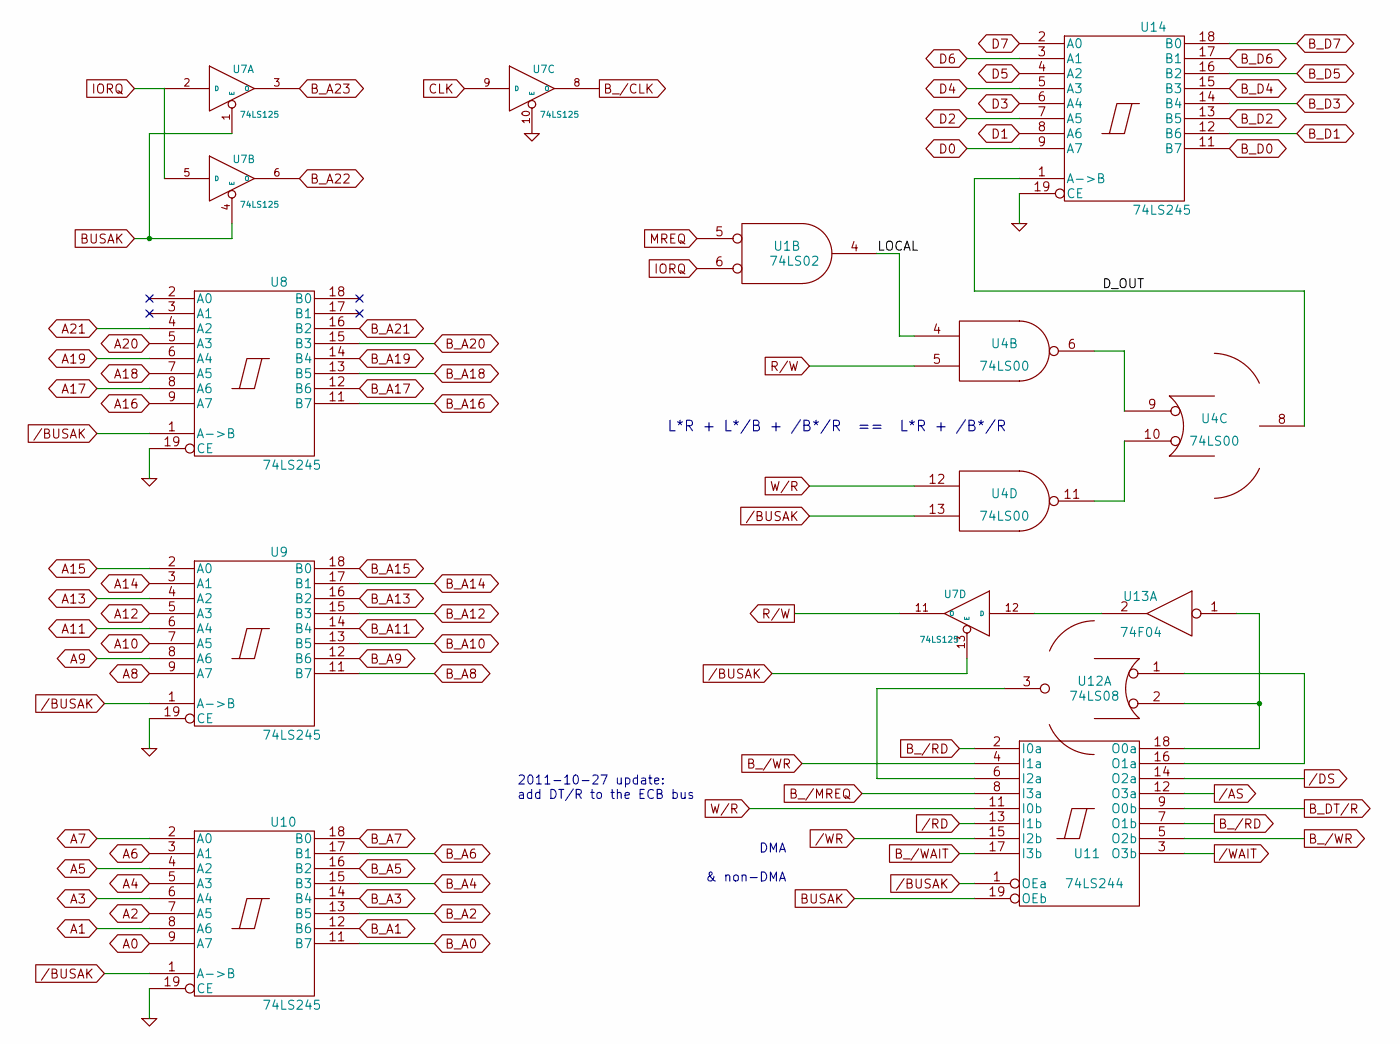
[picture p32: schematic tranceivers-2026-08-16-14-59-02.sch]

Parts:
U1: 74LS02
U4: 74LS00
U7: 74LS125
U8, U9, U10, U14: 74LS245
U11: 74LS244
U12: 74LS08
U13: 74F04

Connections:
/AS: U11.12 (O3a)
/BUSAK: U4.13, U7.13 (E), U8.1 (A->B), U9.1 (A->B), U10.1 (A->B), U11.1 (OEa)
/DS: U11.14 (O2a)
/RD: U11.13 (I1b)
/WAIT: U11.3 (O3b)
/WR: U11.15 (I2b)
A0: U10.9 (A7)
A1: U10.8 (A6)
A2: U10.7 (A5)
A3: U10.6 (A4)
A4: U10.5 (A3)
A5: U10.4 (A2)
A6: U10.3 (A1)
A7: U10.2 (A0)
A8: U9.9 (A7)
A9: U9.8 (A6)
A10: U9.7 (A5)
A11: U9.6 (A4)
A12: U9.5 (A3)
A13: U9.4 (A2)
A14: U9.3 (A1)
A15: U9.2 (A0)
A16: U8.9 (A7)
A17: U8.8 (A6)
A18: U8.7 (A5)
A19: U8.6 (A4)
A20: U8.5 (A3)
A21: U8.4 (A2)
BUSAK: U7.1 (E), U7.4 (E), U11.19 (OEb)
B_/CLK: U7.8 (O)
B_/MREQ: U11.8 (I3a)
B_/RD: U11.2 (I0a), U11.7 (O1b)
B_/WAIT: U11.17 (I3b)
B_/WR: U11.4 (I1a), U11.5 (O2b)
B_A0: U10.11 (B7)
B_A1: U10.12 (B6)
B_A2: U10.13 (B5)
B_A3: U10.14 (B4)
B_A4: U10.15 (B3)
B_A5: U10.16 (B2)
B_A6: U10.17 (B1)
B_A7: U10.18 (B0)
B_A8: U9.11 (B7)
B_A9: U9.12 (B6)
B_A10: U9.13 (B5)
B_A11: U9.14 (B4)
B_A12: U9.15 (B3)
B_A13: U9.16 (B2)
B_A14: U9.17 (B1)
B_A15: U9.18 (B0)
B_A16: U8.11 (B7)
B_A17: U8.12 (B6)
B_A18: U8.13 (B5)
B_A19: U8.14 (B4)
B_A20: U8.15 (B3)
B_A21: U8.16 (B2)
B_A22: U7.6 (O)
B_A23: U7.3 (O)
B_D0: U14.11 (B7)
B_D1: U14.12 (B6)
B_D2: U14.13 (B5)
B_D3: U14.14 (B4)
B_D4: U14.15 (B3)
B_D5: U14.16 (B2)
B_D6: U14.17 (B1)
B_D7: U14.18 (B0)
B_DT/R: U11.9 (O0b)
CLK: U7.9 (D)
D0: U14.9 (A7)
D1: U14.8 (A6)
D2: U14.7 (A5)
D3: U14.6 (A4)
D4: U14.5 (A3)
D5: U14.4 (A2)
D6: U14.3 (A1)
D7: U14.2 (A0)
D_OUT: U4.8, U14.1 (A->B)
GND: U7.10 (E), U8.19 (CE), U9.19 (CE), U10.19 (CE), U14.19 (CE)
IORQ: U1.6, U7.2 (D), U7.5 (D)
LOCAL: U1.4, U4.4
MREQ: U1.5
unnamed: U4.6, U4.9
unnamed: U4.10, U4.11
unnamed: U11.6 (I2a), U12.3
unnamed: U11.16 (O1a), U12.1
unnamed: U11.18 (O0a), U12.2, U13.1
unnamed: U7.12 (D), U13.2
R/W: U4.5, U7.11 (O)
W/R: U4.12, U11.11 (I0b)

Notes on the sheet:
L*R + L*/B + /B*/R == L*R + /B*/R
2011-10-27 update: add DT/R to the ECB bus
DMA & non-DMA
