danwerner21/mini68k/hardware/sbc/rescue-backup/waitState-2026-08-16-14-59-02.sch

## KiCad design hardware/sbc/rescue-backup/waitState-2026-08-16-14-59-02.sch (2026-08-16)

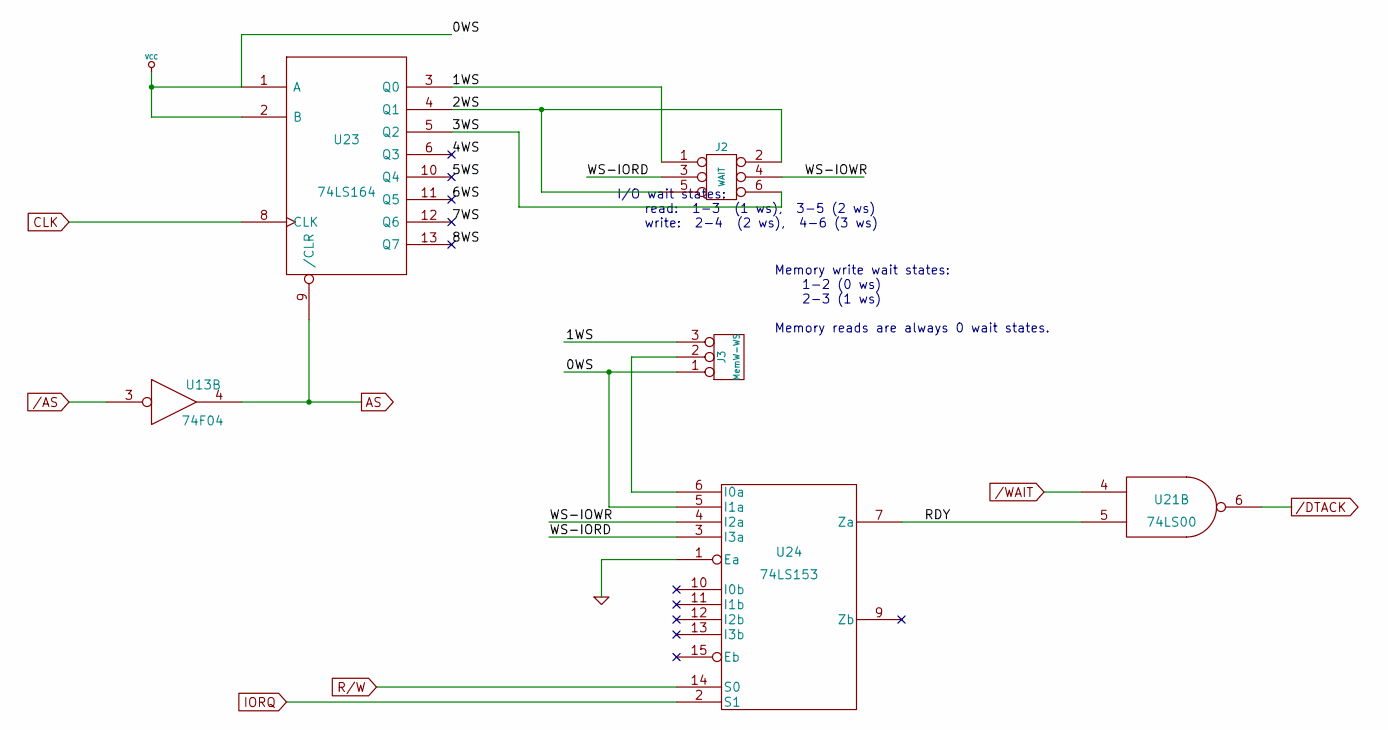
[picture p33: schematic waitState-2026-08-16-14-59-02.sch]

Parts:
J2: WAIT
J3: MemW-WS
U13: 74F04
U21: 74LS00
U23: 74LS164
U24: 74LS153

Connections:
1WS: J2.1, J3.3, U23.3 (Q0)
2WS: J2.2, J2.5, U23.4 (Q1)
3WS: J2.6, U23.5 (Q2)
4WS: U23.6 (Q3)
5WS: U23.10 (Q4)
6WS: U23.11 (Q5)
7WS: U23.12 (Q6)
8WS: U23.13 (Q7)
/AS: U13.3
/DTACK: U21.6
/WAIT: U21.4
AS: U13.4, U23.9 (/CLR)
CLK: U23.8 (CLK)
GND: U24.1 (Ea)
IORQ: U24.2 (S1)
unnamed: J3.2 (PM), U24.6 (I0a)
R/W: U24.14 (S0)
RDY: U21.5, U24.7 (Za)
VCC: J3.1, U23.1 (A), U23.2 (B), U24.5 (I1a)
WS-IORD: J2.3, U24.3 (I3a)
WS-IOWR: J2.4, U24.4 (I2a)

Notes on the sheet:
Memory write wait states: 1-2 (0 ws) 2-3 (1 ws) Memory reads are always 0 wait states.
I/O wait states: read: 1-3 (1 ws), 3-5 (2 ws) write: 2-4 (2 ws), 4-6 (3 ws)
