danwerner21/mini68k/bios/bios-10.2/ppide2.c

/* ppide2.c		*/
/*
	Copyright (C) 2011 John R. Coffman.
	Licensed for hobbyist use on the N8VEM baby M68k CPU board.
***********************************************************************

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
**********************************************************************/
#include "myide.h"

const struct OPERATION ppide_operations = {
	ppide_reset,
	ppide_info,
	ppide_read,
	ppide_write,
	ppide_verify,
	NULL
};

int ppide_reset  (struct DISK *i)
{
	return 0;
}

int ppide_info   (struct DISK *i)
{
	return 0;
}


int ppide_read   (struct DISK *i, dword sector, byte *buffer)
{
	return 0;
}

int ppide_write  (struct DISK *i, dword sector, byte *buffer)
{
	return 0;
}

int ppide_verify (struct DISK *i, dword sector)
{
	return 0;
}

int ppide_format (struct DISK *i, byte *interleave)
{
	return 0;
}
