danwerner21/mini68k/bios/bios-10.2/optab.h

/* struct for optab */
struct optbl {
    short inmsk;
    short invalu;
    short infmt;
    char *innam;
};
 
#define MAXFMT  28
#define OPENT 4   /* # words per line in optab */

const struct optbl optab[] = {
    { 0xffff, 0x023c, 3,      "andi.b" },
    { 0xffff, 0x027c, 3,      "andi.w" },
    { 0xffff, 0x0a3c, 3,      "eori.b" },
    { 0xffff, 0x0a7c, 3,      "eori.w" },
    { 0xffff, 0x4afa, 0,      "illegal" },
    { 0xffff, 0x4afb, 0,      "illegal" },
    { 0xffff, 0x4afc, 0,      "illegal" },
    { 0xffff, 0x4e71, 0,      "nop" },
    { 0xffff, 0x003c, 3,      "ori.b" },
    { 0xffff, 0x007c, 3,      "ori.w" },
    { 0xffff, 0x4e70, 0,      "reset" },
    { 0xffff, 0x4e74, 21,     "rtd" },
    { 0xffff, 0x4e73, 0,      "rte" },
    { 0xffff, 0x4e77, 0,      "rtr" },
    { 0xffff, 0x4e75, 0,      "rts" },
    { 0xffff, 0x4e72, 21,     "stop" },
    { 0xffff, 0x4e76, 0,      "trapv" },
    { 0xfffe, 0x4e7a, 24,     "movec" },
    { 0xfff8, 0x50c8, 12,     "dbt" },
    { 0xfff8, 0x51c8, 12,     "dbra" },	/* was "dbf" */
    { 0xfff8, 0x52c8, 12,     "dbhi" },
    { 0xfff8, 0x53c8, 12,     "dbls" },
    { 0xfff8, 0x54c8, 12,     "dbcc" },
    { 0xfff8, 0x55c8, 12,     "dbcs" },
    { 0xfff8, 0x56c8, 12,     "dbne" },
    { 0xfff8, 0x57c8, 12,     "dbeq" },
    { 0xfff8, 0x58c8, 12,     "dbvc" },
    { 0xfff8, 0x59c8, 12,     "dbvs" },
    { 0xfff8, 0x5ac8, 12,     "dbpl" },
    { 0xfff8, 0x5bc8, 12,     "dbmi" },
    { 0xfff8, 0x5cc8, 12,     "dbge" },
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
    { 0xf1c0, 0x5180, 4,      "subq.l" },
    { 0xf100, 0x7000, 20,     "moveq.l" },
    { 0xf000, 0x1000, 16,     "move.b" },
    { 0xf000, 0x3000, 16,     "move.w" },
    { 0xf000, 0x2000, 16,     "move.l" },
    { 0x0000, 0x0000, 0,      "*unknown instruction*" }
};
