danwerner21/mini68k/bios/bios-10.2/myide.h

/*  myide.h  */
/*
	Copyright (C) 2011 John R. Coffman.
	Licensed for hobbyist use on the N8VEM baby M68k CPU board.
***********************************************************************

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
**********************************************************************/
#ifndef _MYIDE_H
#define _MYIDE_H 1
#include "mytypes.h"

#define MAX_DISK 8			/* allow up to 8 disks on the system */


enum BOARD_TYPE { B_NONE, B_PPIDE, B_DIDE, B_DISKIO, B_DUALSD,
						B_noBoard };

enum DISK_TYPE {D_NONE, D_FLOPPY_1200=2, D_FLOPPY_720, D_FLOPPY_1440,
					D_PPIDE=8, D_DIDE, D_DISKIO, D_DIDE_8, D_DUALSD };

enum IDE_MS {MASTER=0, SLAVE=0x10};

typedef
struct GEOMETRY {
	word	cylinders;		/* number of cylinders   [0 .. c-1]		*/
	byte	heads;			/* number of heads/tracks  [0 .. h-1]	*/
	byte	sectors;			/* number of sectors/track  [1 .. s]	*/
} T_geometry;


typedef
struct DISK {
	struct OPERATION const *op;		/* pointer to operation vectors */
	
	dword	lba_cyls;		/* LBA number of cylinders */

	byte	disk_type;		/* from the ENUM above */
	byte	port;				/* word for MSDOS */
	byte	slave;			/* IDE subtype information */
	byte	status;			/* last error status */

	T_geometry geom;		/* geometry information */
} T_disk;

typedef
struct OPERATION {
	int (*reset) (struct DISK *i);
	int (*info) (struct DISK *i);
	int (*read) (struct DISK *i, dword sector, byte *buffer);
	int (*write) (struct DISK *i, dword sector, byte *buffer);
	int (*verify) (struct DISK *i, dword sector);
	int (*format) (struct DISK *i, byte *interleave);
} T_operation;



T_disk *disk_table[MAX_DISK];		/* master table of disk drives */



/*
		Declarations of the disk I/O procedures
*/

int any_diskop(
		int diskno, 		/* D1 */
		int lba_sector, 	/* D2 */
		int nsects,			/* D3 */
		byte *buffer		/* A0 */
		);

int floppy_reset  (struct DISK *i);
int floppy_info   (struct DISK *i);
int floppy_read   (struct DISK *i, dword sector, byte *buffer);
int floppy_write  (struct DISK *i, dword sector, byte *buffer);
int floppy_verify (struct DISK *i, dword sector);
int floppy_format (struct DISK *i, byte *interleave);

int ppide_reset  (struct DISK *i);
int ppide_info   (struct DISK *i);
int ppide_read   (struct DISK *i, dword sector, byte *buffer);
int ppide_write  (struct DISK *i, dword sector, byte *buffer);
int ppide_verify (struct DISK *i, dword sector);
int ppide_format (struct DISK *i, byte *interleave);

int dide_reset  (struct DISK *i);
int dide_info   (struct DISK *i);
int dide_read   (struct DISK *i, dword sector, byte *buffer);
int dide_write  (struct DISK *i, dword sector, byte *buffer);
int dide_verify (struct DISK *i, dword sector);
int dide_format (struct DISK *i, byte *interleave);

int dsd_reset  (struct DISK *i);
int dsd_info   (struct DISK *i);
int dsd_read   (struct DISK *i, dword sector, byte *buffer);
int dsd_write  (struct DISK *i, dword sector, byte *buffer);
int dsd_verify (struct DISK *i, dword sector);
int dsd_format (struct DISK *i, byte *interleave);

#endif	/*  _MYIDE_H  */
