danwerner21/mini68k/bios/bios-10.2/ns202.h

/* ns202.h	*/
/*
	Copyright (C) 2011 John R. Coffman.
	Licensed for hobbyist use on the N8VEM baby M68k CPU board.
***********************************************************************

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
**********************************************************************/
/*	*/
/*   Register definitions for the NS32202 interrupt controller	*/
/*	*/
/*	*/
#ifndef _ns202_h
#define _ns202_h 1
#include  "mfpic.h"

#define icu_reg(x) (mf_202 + (x)*256)

/* hvct	        =  0	     b	  hardware vector - read by INTA only	*/
#define hvct icu_reg(0)
/* svct	        =  1	     b	  software vector - pending	*/
#define svct icu_reg(1)
/* svcti           =  svct+32   b   software vector - in service	*/
#define svcti icu_reg(1+32)
/* eltg	        =  2	     w	  edge/level triggering	*/
#define eltg icu_reg(2)
/* tpl	        =  4	     w	  triggering polarity	*/
#define tpl icu_reg(4)
/* ipnd	        =  6	     w	  interrupts pending	*/
#define ipnd icu_reg(6)
/* isrv	        =  8	     w	  interrupts in service	*/
#define isrv icu_reg(8)
/* imsk	        = 10	     w	  interrupt mask	*/
#define imsk icu_reg(10)
/* csrc	        = 12	     w	  cascaded source	*/
#define csrc icu_reg(12)
/* fprt	        = 14	     w	  first priority	*/
#define fprt icu_reg(14)
/* mctl	        = 16	     b	  mode control	*/
#define mctl icu_reg(16)
/* ocasn	        = 17	     b	  output clock assignment	*/
#define ocasn icu_reg(17)
/* ciptr	        = 18	     b	  counter interrupt pointer	*/
#define ciptr icu_reg(18)
/* pdat	        = 19	     b	  port data	*/
#define pdat icu_reg(19)
/* ips	        = 20	     b	  interrupt/port select	*/
#define ips icu_reg(20)
/* pdir	        = 21	     b	  port direction	*/
#define pdir icu_reg(21)
/* cctl	        = 22	     b	  counter control	*/
#define cctl icu_reg(22)
/* cictl	        = 23	     b	  counter interrupt control	*/
#define cictl icu_reg(23)
/* lcsv	        = 24	     w	  l-counter starting value	*/
#define lcsv icu_reg(24)
/* hcsv	        = 26	     w	  h-counter starting value	*/
#define hcsv icu_reg(26)
/* lccv	        = 28	     w	  l-counter current value	*/
#define lccv icu_reg(28)
/* hccv	        = 30	     w	  h-counter current value	*/
#define hccv icu_reg(30)

/* eoi             = hvct+32    b   read for End Of Interrupt signal	*/
#define eoi icu_reg(0+32)


/* counter_clock	=	1843200     input counter (no prescaling yet) */
#define counter_clock 1843200
#define hertz (counter_clock/4)

#define high_byte 25
/*	results in 18.962963 Hz clock
	one day's tick count is 0x00190000  or  25<<16
*/


/*    xwxwxwxwbbbbbbbbxwxwxwxwxwxwxwbb	*/
/*    01010101000000000101010101010100	*/

/*    0101 0101 0000 0000 0101 0101 0101 0100	*/
/*    0x55005554	*/
/*    0xFFFC,0xFF00	*/

#endif
