danwerner21/mini68k/bios/bios-10.2/debug.h

/* debug.h  -- Declarations for the mini-M68k debugger  */
/*
	Copyright (C) 2011-2016 John R. Coffman.
	Licensed for hobbyist use on the N8VEM baby M68k CPU board.
***********************************************************************

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
**********************************************************************/
#ifndef _DEBUG_H
#define _DEBUG_H 1
#include "mytypes.h"

#define BREAK_LIMIT_LOW 0x1000
#if CPU<68010
#define BREAK_LIMIT_HIGH 0x00380000
#define BREAK_LIMIT_MASK 0x003FFFFF
#else
#define BREAK_LIMIT_HIGH 0xFFF00000
#define BREAK_LIMIT_MASK 0xFFFFFFFF
#endif

extern
struct STATUS {
	long	d[8];
	long	a[7];		/* saved A7 is always SSP */
	long	ssp;		/* A7 == Supervisor SP (probably ISP) */
	long	usp;		/* the USP */
	long	pc;
	word	frame;		/* bit 15 is frame invalid bit */
	word	sr;		/* high word MBZ; low word is SR */
#if CPU>68010
	long	isp;		/* ISP on 68020 */
	long	msp;		/* MSP on 68020 */
#endif
} state;

typedef
struct BREAK {
	long	where;	/* word location of the breakpoint */
	word	instr;	/* original instruction at the location */
	word	status;	/* status bits */
} T_break;

#define	MAXBREAKS  16	/* maximum number of breakpoints */
		/* actually there is one more, break[0] is used to step over a call */
#define	INSBREAK		0x4AFC		/* ILLEGAL instruction */
/* status bits:			*/
#define BR_USED	0x01		/* breakpoint entry is used */
#define BR_ENBL	0x02		/* breakpoint is enabled ==> used is set */


/* definition for symbol table usage */
typedef
struct SYMBOL {
	long	value;	/* value of the symbol */
	char *name;		/* pointer to the name string */
	word	length;	/* strlen(name) */
} T_symbol;


void debug68(int);
void Trace(int);
void Go(int);

void install_breaks(void);
void remove_breaks(void);

#endif
