danwerner21/mini68k/bios/cpm68e/rom/DISK/ASSERT.H

/* ASSERT macro */

#ifndef NDEBUG
#define ASSERT(expr) {if(!(expr)) printf("assertion failed: expr\n");}
#else
#define ASSERT(expr)
#endif 

#ifndef NDEBUG
#define ASSERT(expr) {if(!(expr)) printf("assertion failed: expr\n");}
#else
#define ASS
