danwerner21/mini68k/bios/cpm68e/rom/DISK/BIOSTYPS.H

/*	@(#)biostyps.h	1.1		*/
/************************************************/
/*						*/
/*	Portable type definitions for use  	*/
/*	with the C BIOS according to 		*/
/*	CP/M-68K (tm) standard usage.		*/
/*						*/
/************************************************/

#define LONG	long
#define ULONG	unsigned long
#define WORD	short int
#define UWORD	unsigned short
#define BYTE	char
#define UBYTE	unsigned char
#define VOID	

#define REG	register
#define LOCAL	auto
#define MLOCAL	static
#define GLOBAL	extern
#define EXTERN	extern

/************************************************/
to
#define MLOCAL	static
#def
