danwerner21/mini68k/bios/cpm68e/rom/DISK/LOADBIOS.H

/*	@(#)loadbios.h	1.3		*/
#define LOADER  1
#define CTLTYPE 0
#define MEMDSK 0
#define DISKB	0
#define DISKC	5
#define DISKD	0
#define	NO_ASM_SUPPORT	0

LOADER  1
#define CTLTYPE 0
#define MEMDSK 0
#define DISKB	0
#define DISKC	5
#define DIS
