danwerner21/mini68k/(notices)

Notices in the files:
hardware/sbc/babyM68K.brd:
Copyright (c) 2013 John R Coffman
hardware/mfpic/$savepcb.brd:
Copyright (c) 2014 John R. Coffman
